rushikesh3982/tdeck-phone/case/README.md

# Case files

Modified from **"Lilygo T-Deck TD1 Case" by Alley Cat**, Printables model 741124,
https://www.printables.com/model/741124-lilygo-t-deck-td1-case, licensed
[CC BY-SA 4.0](https://creativecommons.org/licenses/by-sa/4.0/). The STL files and images in this folder are
changed versions of that design and are shared under the same licence, CC BY-SA 4.0. The originals are on
Printables. (The script in `scripts/` is MIT, like the rest of the repository.)

> **Print these cases in ASA only.** Every file here is built 1 % larger to allow for how much ASA shrinks as it
> cools, and that is what fits the T-Deck and the parts. PLA, PLA+ and PETG shrink less, so in those the parts come
> out too large and the T-Deck sits loose. ASA also stands up to the heat of a pocket or a car far better than PLA.

**Folders:** one per version of the case, each with `stl/` (every piece to print, already 1 % larger: print them at
100 % in the slicer) and `images/` (the pictures in its notes):
- [x-back-5000mah/](x-back-5000mah/): the build described on this page, the X back with the 5000 mAh pouch.
- [18650/](18650/): the slimmer 18650 version, described in [../docs/design-18650.md](../docs/design-18650.md).

Shared by both: [scripts/](scripts/) (the programs that make the STL files and pictures) and [logo/](logo/) (the
logos they engrave).

| File | What it is | Changed from |
|---|---|---|
| [x-back-5000mah/stl/front-earpiece-mic.stl](x-back-5000mah/stl/front-earpiece-mic.stl) | Front, with earpiece grille, mic pocket, a second SMA antenna cut-out, a microSD-direction picture beside the microSD opening, Alley Cat's left-side switch mount kept for the modem's SS-12F15 switch, and Alley Cat's cat-head logo on the top-edge badge | `Alley Chat TD1 Standard Front GPS Inserts.stl` |
| [x-back-5000mah/stl/earpiece-holder.stl](x-back-5000mah/stl/earpiece-holder.stl) | Small block that fills the earpiece pocket and holds the earpiece on the grille slot | new part, sized to the front's pocket |
| [x-back-5000mah/stl/back-modem-gps.stl](x-back-5000mah/stl/back-modem-gps.stl) | Back with modem standoffs, SIM slit (with a picture showing which way the card goes), GPS patch cradle, network-LED window, the back's half of the old GPS-module slot filled, and the rushiWorks logo on the outside (first version: print and dry-fit) | `Alley Chat TD1 X Back Outside Cat Edition.stl` |

Alley Cat's small parts are included **unchanged**, copied from the same Printables download (same licence and
credit). They're only scaled by 1 % like the rest of the set (see the folder note below), and copied into each
version's folder, so everything to print for this build is in [x-back-5000mah/stl/](x-back-5000mah/stl/):

| File | What it is | Original file |
|---|---|---|
| [x-back-5000mah/stl/alley-chat-td1-switch.stl](x-back-5000mah/stl/alley-chat-td1-switch.stl) | Slider for the T-Deck's own power switch (right side). Needed | `Alley Chat TD1 Switch.stl` |
| [x-back-5000mah/stl/alley-chat-td1-reset-button.stl](x-back-5000mah/stl/alley-chat-td1-reset-button.stl) | Button for the T-Deck's reset (left side). Needed if you want to reach reset from outside | `Alley Chat TD1 Reset Button.stl` |
| [x-back-5000mah/stl/alley-chat-td1-x-antenna-plug-gsm.stl](x-back-5000mah/stl/alley-chat-td1-x-antenna-plug-gsm.stl), [...-lora.stl](x-back-5000mah/stl/alley-chat-td1-x-antenna-plug-lora.stl) | Blanks off an SMA hole that has no connector in it: two identical copies, one for the 4G (GSM) hole (top-right) and one for the LoRa hole (top-left). **Needed only for a hole left empty**, for example the 4G hole with an internal antenna. With SMA antennas, both holes carry a connector (LoRa top-left, 4G top-right) | `Alley Chat TD1 X Antenna Plug.stl` |

**Size:** the files are **built 1 % larger** than Alley Cat's originals, because that's what fits our T-Deck in ASA
(see [Fit and scale](#fit-and-scale-asa-101-)). They're already scaled, so **print them at 100 % in the slicer**.

**Assembly diagrams** (what every cut-out is for, and where each part goes) and the step-by-step assembly order are in
[../docs/assembly.md](../docs/assembly.md).

## 18650 version (print files ready in 18650/stl/)

A slimmer phone, 26.5 mm instead of 37, with one 18650 cell in a grip across the top of the back. Everything about it
is in [../docs/design-18650.md](../docs/design-18650.md), including which files to print and how. Three scripts make
its parts, and the 101 % print files are in [18650/stl/](18650/stl/): `back-18650.stl` (saved standing on its top
edge, as it prints), `front-18650.stl` and `earpiece-holder-18650.stl`, with copies of Alley Cat's small parts (the
switch slider, the reset button and two antenna plugs), so the folder has every piece to print.

| Script | Part | Changed from |
|---|---|---|
| [scripts/make_back_18650.py](scripts/make_back_18650.py) | Back: the grip and the cell's channel, the modem board below it on 8 mm standoffs, the modem switch on the right wall (Alley Cat's slot and screw holes, copied from her front), the network-light window, the open GPS top slot, two ribs at each end of the cell to hold a battery contact, with + and − engraved beside them, and a thin wall along the cell that carries the protection board, with slits for its nickel strips. Grooves outside, no logo. Her cat and "Alley Chat TD1 S" stay inside | `Alley Chat TD1 S Inside Cat Edition.stl`, 0.5 mm deeper |
| [scripts/make_front_18650.py](scripts/make_front_18650.py) | Front: the SIM slit in a finger scoop, Alley Cat's speaker cavity and grille moved to the right side, larger SIM and microSD pictures, the wider and lower earpiece pocket, a notch in each side wall for a battery contact's top, and the rushiWorks logo on the top badge | the front above (`make_front.py`) |
| [scripts/make_earpiece_holder_18650.py](scripts/make_earpiece_holder_18650.py) | Low earpiece holder, with a flat roof for the GPS antenna to stand on | the earpiece holder below |

The rest of this page describes the current build.

## Front: what changed

Only these changes were made. The outer size and everything else are exactly as the original.

**Earpiece grille.** A 1 × 6 mm slot with rounded ends goes through the 3.6 mm face above the screen. It is
centred under the GPS pocket, which measures 16.4 × 7.3 mm inside.

- The receiver (the Micromax one) lies on the pocket floor, facing the slot, with its rubber gasket against the floor.
  It is 12 × 6 mm and 2 mm thick with the gasket. Its two spring contacts, folded over its back at the short
  ends, make it 3 mm.
- The [earpiece holder](#earpiece-holder) goes in on top of it and keeps it pressed down.

**Microphone.** In the bottom edge, 15 mm left of the USB-C opening as you look at the screen. This is the corner
that points toward your mouth when the phone is at your right ear.

- **The mic:** Sunrom 6027 ([sunrom.com/m/5522](https://www.sunrom.com/m/5522)). Its datasheet gives:
  - **Body:** Ø6.0 ± 0.2 mm, 2.7 ± 0.2 mm tall.
  - **Pins:** two, 2.8 mm long, 0.4 mm thick, 1.9 mm apart.
- **Pocket:** 6.3 mm round, opening on the inside of the case. That leaves 0.1–0.5 mm of play around the mic. Its top
  is pointed (a "teardrop") so it prints without supports.
- **Skin and sound hole:** 1.2 mm of plastic is left at the outside, with a 1.5 mm sound hole through it.
- **Fitting the mic, before the T-Deck goes in:** the pocket opens on the inside face of the bottom wall, which
  the T-Deck covers once it's in. Push the Sunrom 6027 (6 × 2.7 mm) in from inside until it touches the skin. Hold
  it with a dab of glue, lay its wires in the groove, then fit the T-Deck.
- **Wire groove:** a 2.4 mm groove runs from the pocket up the inside wall and through the mating lip, so the
  two mic wires reach the back half without the T-Deck pinching them.
- **Pins and wires:**
  - **Space behind the mic:** the pocket stays open behind the mic body all the way into the case. The only thing
    nearby is the T-Deck's back edge, which reaches 1.3 mm up the pocket's lower (screen-side) edge.
  - **Turn the mic so its two pins sit side by side,** both at the mic's centre height, level with each other and
    parallel to the screen. Then both solder joints are 1.7 mm clear of the T-Deck, and in line with the groove.
  - **Trim the pins to about 1.5 mm,** solder a thin wire to each, and bend the wires up into the groove. Don't let a
    joint hang toward the screen side.

**Alley Cat's cat-head logo on the top-edge badge.** It's a visible credit to the case's designer.

- **Badge:** the original badge (cat ears + GPS pin) is replaced by a fresh one of the same footprint: a 1 mm raised
  pad with 45° bevels and a 16.8 × 10.5 mm face.
- **The cat:** the cat head is taken from Alley Cat's own TD1 files, and is the same cat as on her *Alley Chat HT
  Pocket* case (see [logo/](logo/)). It's 9.4 mm tall and cut the same way as on the HT Pocket: the head recessed
  0.35 mm, the closed eyes and nose 0.7 mm deep.
- **Orientation:** it reads upright when the phone lies screen-up, with the ears toward the screen side.

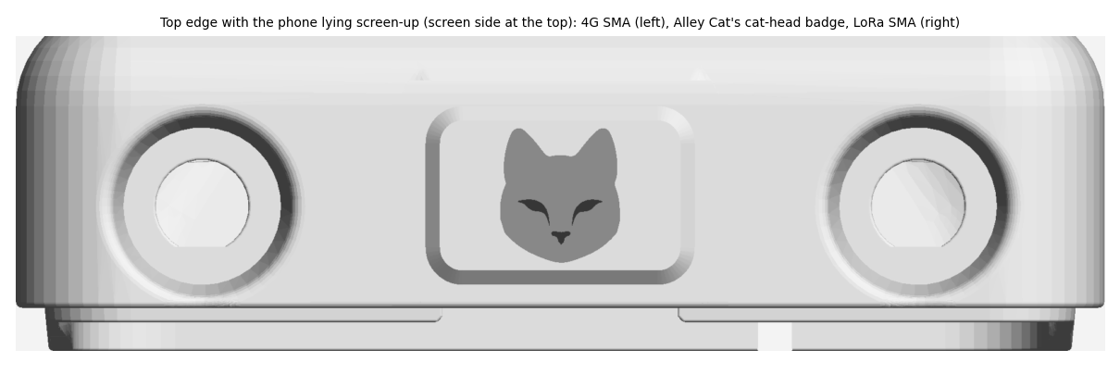
[picture p1: case/images/front-top-edge.png]
Top edge with the phone screen-up: 4G SMA cut-out, Alley Cat's cat-head badge, LoRa SMA cut-out


**Modem switch mount (Alley Cat's original, kept).** The GPS version's slide-switch mount on the left side holds
the modem's on/off switch, an **SS-12F15**. That's the switch the mount was drawn for, with the same 15 mm screw
spacing and 2.2 mm holes.
- **Fitting:** the 19.7 × 5.6 mm plate sits in the 21.6 × 8.4 mm recess inside the wall, held by two M2 countersunk
  screws from outside with nuts inside. The 4 mm knob comes out through the 6.9 × 3.4 mm slot and stands 1 mm proud.
- **Checked against the case files:** the switch, with its knob over its full travel, touches neither half. It sits
  0.5 mm above the T-Deck's back, and its pins point into the case.
- **Battery:** it moves about 9 mm toward the phone's right to clear the switch's body and pins (2.5 mm gap).
- **History:** this mount was filled in an earlier version, when the modem was to follow the T-Deck's own switch. It
  is now exactly as in Alley Cat's file. The Reset Button opening just below is unchanged too.

**Second SMA antenna cut-out (top-right corner).** The Grove socket is desoldered from the T-Deck and the modem
wires are soldered to its pads, so the Grove plug slot in that corner is no longer needed. It is filled in, and the
corner gets an exact mirror image of the case's own SMA cut-out from the top-left corner. Its fit with the KTRON
IPX → SMA-female cable (KSTA0380):

| Cut-out (both corners) | Size | KTRON connector | Fit |
|---|---|---|---|
| Hole through the wall | Ø 6.56 mm | SMA thread 6.35 mm | ✓ 0.2 mm clearance |
| Hex pocket on the inside, 3 mm deep | 8.4 mm across flats | 8 mm hex collar | ✓ snug, and stops it turning when the antenna is tightened |
| Nut recess on the outside, 2.8 mm deep | Ø 12 mm | 8 mm nut + lock washer | ✓ sits just below the surface |
| Wall | 2 mm | 9.5 mm thread (typical) | leaves about 4.7 mm outside for the antenna. Measure yours: it needs at least 9 mm |

- **Check on the T-Deck before printing:** the case's wall block in that corner is 7.8 mm deep. The connector's
  hex collar, crimp and heat-shrink reach about 11–16 mm in from the outer surface. So 3–8 mm of it goes past the
  T-Deck's top edge, level with the T-Deck's back surface. With the Grove socket removed, hold the connector in
  that corner and check that nothing on the T-Deck is in the way. In the top-left corner, the LoRa connector already
  uses the same space.
- **Which antenna where:** see below.

Both top corners now have identical SMA cut-outs, so either antenna can go in either corner. **Recommended:** 4G
in the top-right, and the T-Deck's LoRa connector staying top-left, where it already sits.
From the top-right, the 4G cable drops straight into the empty strip beside the modem board, to its 4G socket on
that side (about 5 cm; the 10 cm cable is plenty). From the top-left, it would have to get around the battery,
which covers the board with only about 1 mm to spare (about 11 cm, so use the 15 cm cable).

**microSD picture (right side, added 7 Nov 2026).** An engraved microSD outline, 5.9 × 8 mm and 0.8 mm deep, on the
flat wall beside Alley Cat's microSD opening. It sits toward the phone's top, at the opening's height, matching the
SIM picture on the back.
- **What's on it:** the card's narrow front section with its step, four raised stripes for the gold contacts, and a
  raised arrow.
- **How to read it:** with the phone screen-up, the picture's top edge (the contacts end) goes in first. The gold
  contacts face up, toward the screen, which is why they're drawn. The narrow section with its step is on the
  USB-end side.
- **Where the direction comes from:** the owner's photo of a card beside the T-Deck's slot, 7 Nov 2026. LilyGO's
  documentation doesn't say which way it goes.

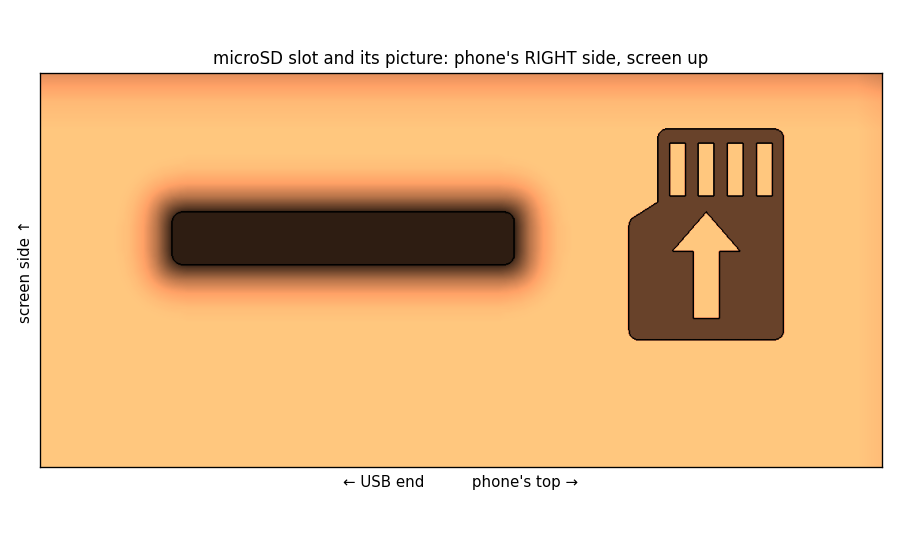
[picture p2: case/images/sd-picture.png]
The microSD opening and the picture beside it, on the phone's right side


## Earpiece holder

[x-back-5000mah/stl/earpiece-holder.stl](x-back-5000mah/stl/earpiece-holder.stl) is a new printed part, 16.0 × 6.9 × 16.5 mm. It fills the front's old
GPS-module pocket and keeps the earpiece pressed onto the grille slot. In the GPS version of the case, the
module's slot ran from the front up into the back. The back's half is now filled solid (see the back changes
below), so the holder only fills the front's part.

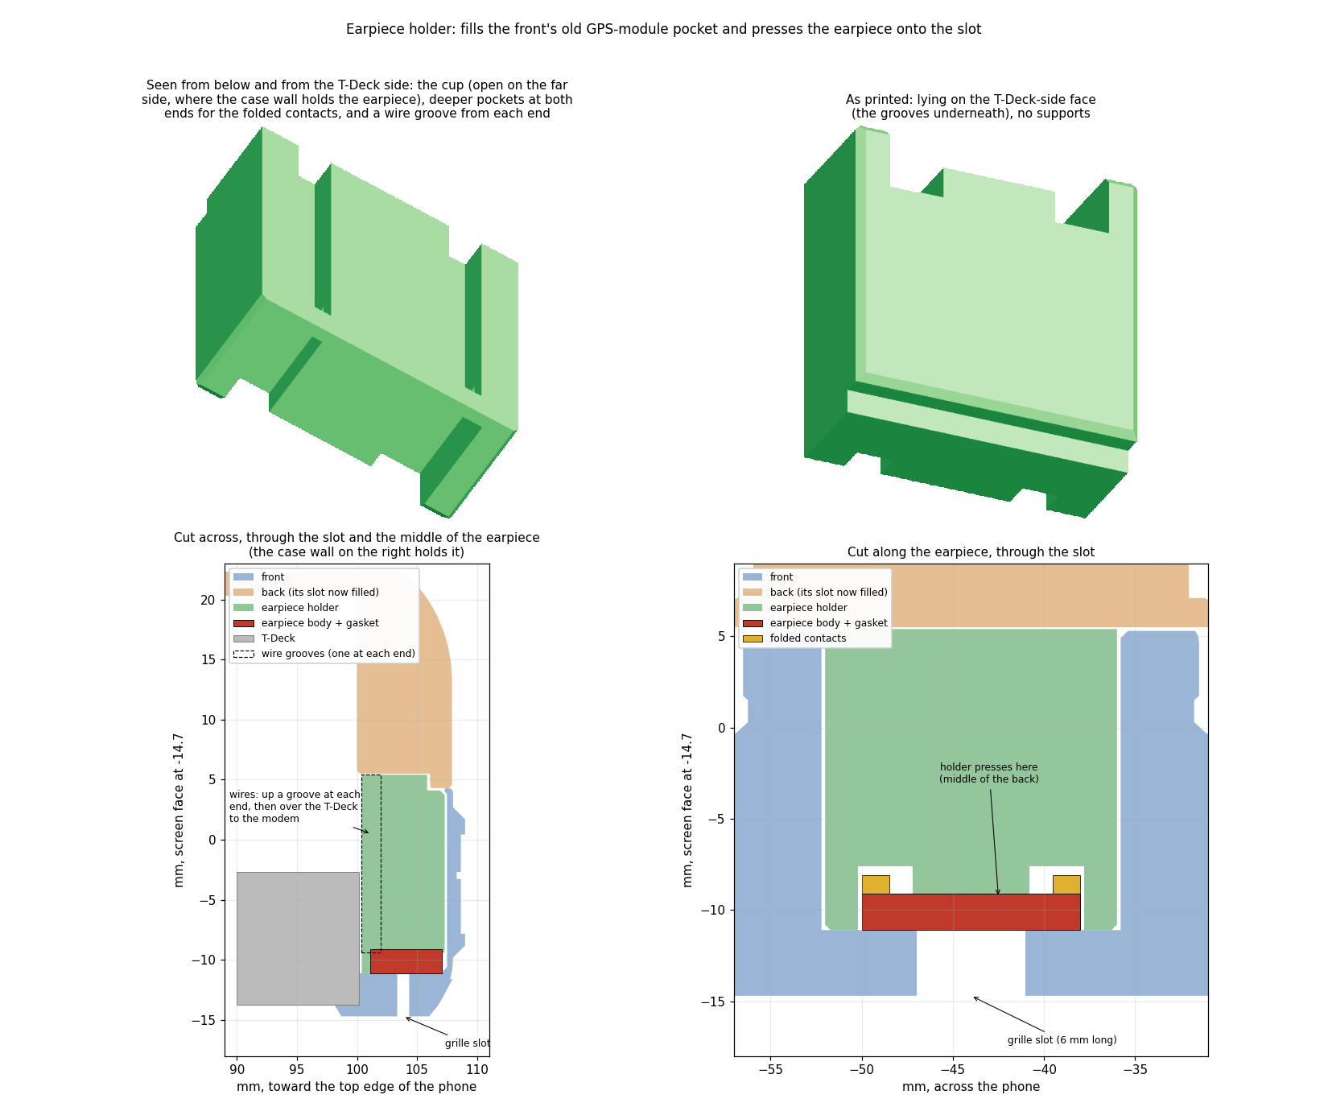
[picture p3: case/images/earpiece-holder.png]
Earpiece holder: views, and a cut through the closed case


- **Cup:** the earpiece sits in a 12.4 mm long cup on the holder's underside, over the slot.
  - **Sides:** the holder is only 6.9 mm wide, too narrow for a wall on both sides of a 6 mm earpiece. So the cup
    has a 0.7 mm wall on the T-Deck side only, and is open on the far side. There the pocket's own wall holds the
    earpiece, with 6.4 mm of room between the two walls.
  - **Middle:** the cup is 1.7 mm deep here, and the holder presses on the middle of the earpiece's back. That squeezes
    the 2 mm body and gasket 0.3 mm onto the pocket floor, sealing the sound path to the slot.
  - **Ends:** over the last 3 mm at each end the cup is 3.5 mm deep. That leaves room for the folded contacts (1 mm)
    and their solder joints.
- **Held by the back:** the holder stands on the pocket floor, and its top ends 0.1 mm under the back's filled block.
  Once the case is closed, it can't lift.
- **Wires:** each end pocket has its own 2 mm groove up the face toward the T-Deck. Each wire goes straight up from
  its solder joint, then over the T-Deck to the modem.
- **Fit:** 0.2 mm clearance all round in the pocket. The script checks that it touches neither case half.
- **If your earpiece measures differently:** the length and width are set at the top of
  `scripts/make_earpiece_holder.py` (`EAR_L`, `EAR_W`). Change them and run it again.
- **Printing:** lay it on the face with the wire grooves (the face toward the T-Deck). Then no supports are needed.

## Back: what changed

**Outside.** Made from Alley Cat's *Outside Cat* edition of the X back. It has the same vertical grooves, with the
three middle ones shortened, which leaves a clear area near the top. That area had a cat-head outline engraved in
it. The cat is filled flush, and the **rushiWorks logo** is engraved in its place:

- **Size:** 24 × 17 mm, 1 mm deep, matching the grooves. The letter strokes are about 0.8 mm wide.
- **Clearances:** it stays clear of the grooves and of the two case-screw countersinks.
- **Orientation:** it reads normally when you look at the back with the phone upright.
- **Printing:** the back prints face-down, so the logo forms in the first layers and comes out crisp.
- **Inside:** identical to the Inside Cat edition, so all the changes below are the same with either.
- **Inside floor:** Alley Cat's engraved cat head and "Alley Chat TD1 X" text (hidden once assembled) are filled
  flat. The designer is credited by the badge kept on the front's top edge and in the README.

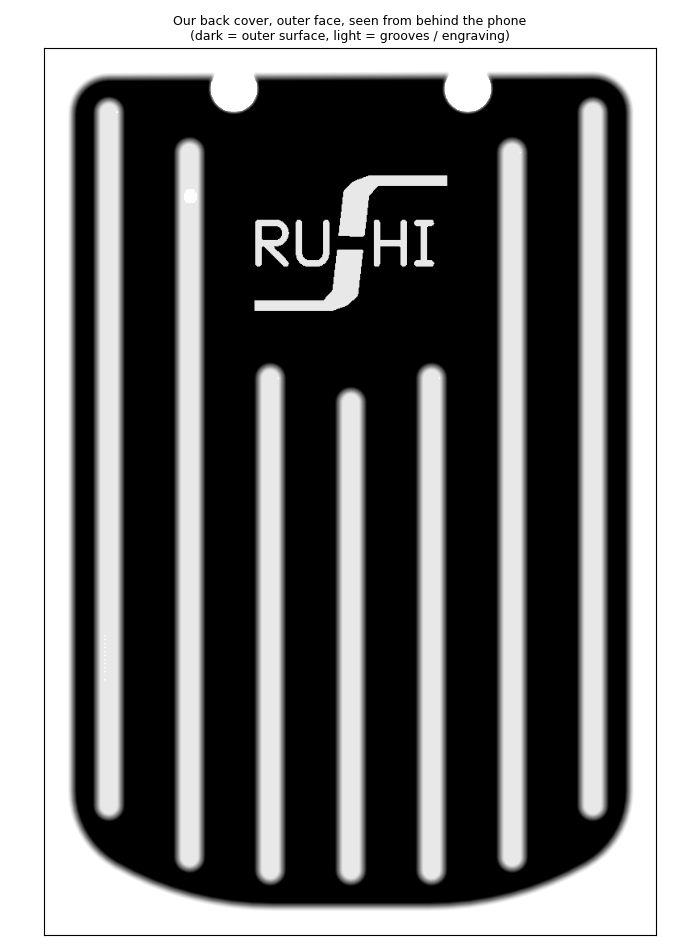
[picture p4: case/images/back-outside.png]
Back cover from outside: Outside Cat groove layout with the rushiWorks logo


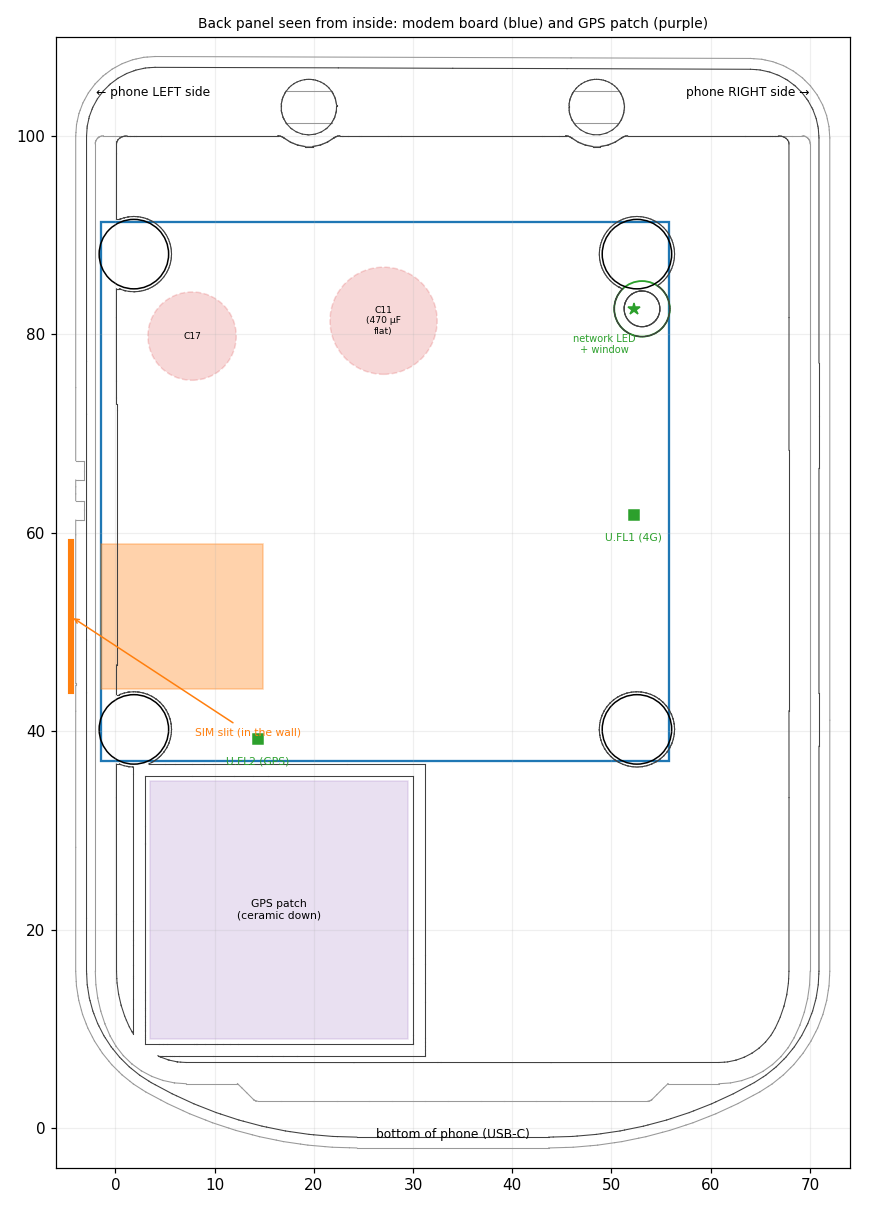
[picture p5: case/x-back-5000mah/images/back-layout.png]
Back from inside: layout of the modem board and GPS patch


**Old GPS-module slot filled.** The GPS version's module slot continued from the front's pocket up into the back:
16.4 × 6.1 mm, 10 mm tall, in the thick block between the two case-screw holes. Only the earpiece uses the
front's part of it now, so the back's part is filled solid. The fill copies the block's cross-section from just beside
the slot, so the block now runs unbroken between the screw holes and caps the earpiece holder.

**Layout change (7 Nov 2026), after the dry fit:**
- **The problem:** the earpiece wires come down from the top, past the filled block between the case screws. The
  board and battery left them only about 1.5 mm.
- **What moved:**
  - **The GPS patch:** 5 mm left and 4 mm down, as far into the bottom-left corner as it can go with its ceramic
    still flat on the pads. Its fence merges into the curved corner.
  - **The modem board:** 7 mm down, with its standoffs, the SIM slit and its picture, and the network-LED window.
  - **The battery and protection board:** 7 mm down too, so the J3 pads stay at the battery's top end.
- **The result:**
  - about 8.5 mm between the battery's top end and the block, room for the earpiece wires;
  - about 5 mm more between the GPS patch and the internal 4G sticker antenna (about 28 mm edge to edge).

**Modem standoffs.** Four columns at the KTRON board's holes.

- **Board:** the KTRON is 54.33 × 57.23 mm, with its holes on a 47.90 × 50.70 mm rectangle.
- **Columns:** 7 mm wide, with a 10 mm foot, and their tops 9 mm above the inside floor. The two next to the left
  wall are joined to it.
- **Trimmed to the case's shape:** the cover's bottom edge is rounded, so near the floor its outside face curves in.
  The two left columns' feet used to poke up to 1.5 mm out through that curve. Everything added to the back is now
  trimmed to the original cover's outer shape, so nothing shows outside (fixed 6 Nov 2026).

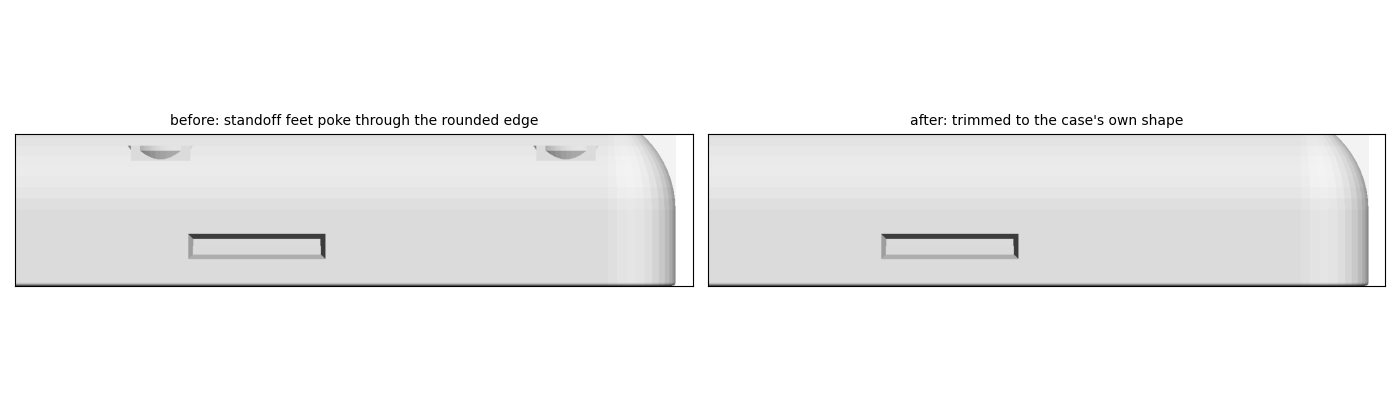
[picture p6: case/images/back-left-edge-fix.png]
Left side of the back from outside, before and after the fix
  
- **Inserts:** each column has a 4.5 mm hole, 6 mm deep, for an M3 × 5 heat-set insert. The board is held with
  M3 × 6 screws from its solder side.
- **Board orientation:** component side down toward the back cover. The SIM edge faces the phone's left side,
  0.6 mm from the wall. The 4G socket faces right, and the GPS socket is at the bottom, just above the patch.
- **9 mm only works after the capacitor swap.** The KTRON's two 11 mm tall capacitors are replaced by radial
  ones laid flat (see [../docs/bring-up.md](../docs/bring-up.md), phase B). Nothing on the board's component side
  may stand more than 8 mm high.

**SIM slit.** Through the left side wall, in line with the SIM holder.

- **Size:** 15 × 1.8 mm on the inside, flaring to about 16 × 3 mm on the outside so the card finds its way in.
- **Position:** its centre is 11.35 mm above the inside floor and 4.65 mm below the rim, so it is entirely in the
  back panel. That is the card's height in a standard 1.5 mm push-push micro-SIM holder sitting on a board on 9 mm
  standoffs.
- **Using it:** push the card in until it clicks, using a fingernail or a SIM pin. Push again to release it, then
  pull it out.
- **SIM size:** a nano-SIM in a micro adapter can catch in push-push holders. A fresh multi-cut SIM, popped out at
  micro size, is safer.
- **Which way (picture beside the slit, added 7 Nov 2026):** a micro-SIM outline, 6 × 7.5 mm and 0.8 mm deep,
  with its cut corner and a raised arrow. It's on the flat wall just beside the slit, toward the phone's top, at
  the slit's height.
  - **How to read it:** it's the card as it should look going in, with the phone screen-up. The picture's top edge
    goes in first. The face you see is the face that's up, so the gold contacts face down. The cut corner is on the
    outer end, toward the phone's USB end.
  - **Why it's needed:** turned end-to-end, the card still clicks in but isn't read.
  - **How it was checked:** on the board and against KTRON's own photo.
  - **Why beside the slit:** a first version sat under the slit, but the wall there is flat for only about 3 mm
    before it curves into the back's rounded edge, which spoiled it.

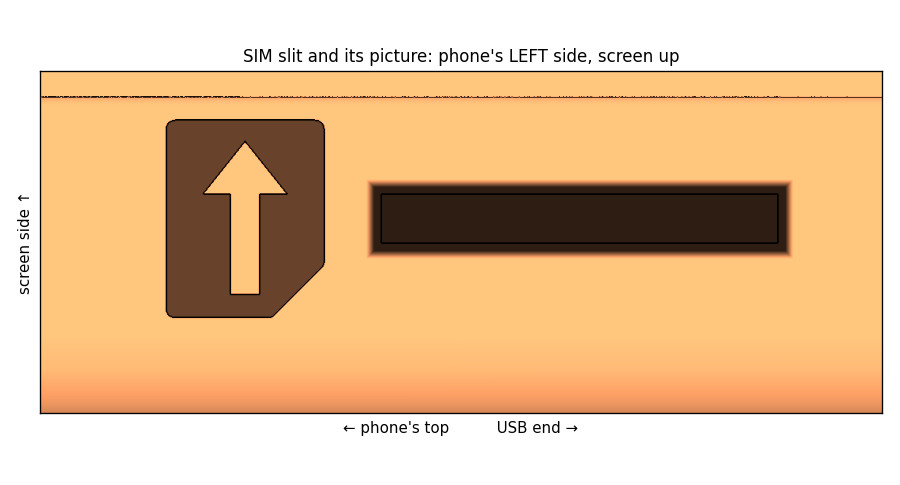
[picture p7: case/x-back-5000mah/images/sim-picture.png]
The SIM slit and the picture beside it, on the phone's left side
  

The SIM slit is also shown from outside in the "after" half of the picture under *Modem standoffs* above (drawn
before the SIM picture was added).

**GPS patch cradle.** A fence with a 27 mm square opening in the bottom-left corner. It is sized for the measured patch:
26 × 26 mm board and a 25 × 25 × 4 mm ceramic that sits slightly crooked.

- **Pads:** the ceramic faces down and rests on four 3 mm pads, 0.5 mm high, so it stays just off the cover.
- **Fence:** 7 mm tall.
- **Cable notches:** 4 mm wide, in every side, for the cable that leaves the middle of one side of the board.
- **Fixing:** a dab of hot glue at two corners. The 95 mm cable easily reaches the GPS socket, just above the patch.

**Network LED window.** The KTRON's network LED (NETLIGHT) faces the back cover from 9 mm up.

- **Light tube:** 3.6 mm bore, from the floor to 1.6 mm under the board, so the light goes straight out and the
  power LED next to it doesn't leak through.
- **Hole:** 1.6 mm through the cover, on the flat floor of the decorative groove beside the LED (1 mm thick there).
- **Where it shows:** near the top of the back, on the phone's right side. When you look at the back, that's the
  top-left area.
- **Blink pattern** (SIMCom): lit steadily while searching for the network; 200 ms on / 200 ms off once
  registered.
- **Optional:** a drop of clear glue or UV resin seals the hole and spreads the light.

**Internal LTE antenna option.** The full-band LTE sticker antenna (110 × 20 mm) can go along the inside of the back's
right side, wrapped from the floor up the wall. It needs no change to the case files. The band beside the modem board is
about 7.5 mm of flat floor, a curve, and 16 mm of wall, about 91 mm long. Details, and how to decide by measuring, are
in [../docs/wiring.md](../docs/wiring.md), section 6. With it, the top-right SMA hole takes the antenna plug.

**Depth** (inside floor to the T-Deck's back, 23 mm with LilyGO's 11 mm T-Deck): 9 standoffs + 1.6 board + 1.5 SIM
holder + 1 foam + 9 battery = 22.1 mm. The battery (65 × 55 × 9 mm) lies over the board, its long side running top
to bottom, with its connector end toward the bottom, over the patch.

## Fit and scale (ASA, 101 %)

**Our result (7 Nov 2026):** the parts built at **101 %**, printed in **ASA**, fit the T-Deck and all the parts
well. That matches other builders' reports: ASA shrinks a little more than PLA or PETG as it cools. So the
files in each version's `stl/` folder are the 101 % set, for ASA only.

**The T-Deck's fit is tight on purpose.** For the first 5 mm above the screen face, the front's inside is exactly
68.00 mm wide. That's LilyGO's width for the T-Deck, with no clearance. Above that, a 1.5 mm tall ridge narrows it to
67.4–67.5 mm. The ridge snaps over the T-Deck's sides and holds it without screws, and the case is meant to flex as
the T-Deck goes in. So whether it fits depends on how your printer and filament come out, to a few tenths of a
millimetre.

**What other builders report** (Printables comments, 2024–2026):
- Most printed at 100 % in PETG, PLA, PLA+ or ABS and say it "fits like a glove". The designer uses PETG.
- Those printing ASA needed 0.5–1 % larger. ASA shrinks more as it cools.
- One printed at 102 % and needed a shim to stop the T-Deck shifting, so 102 % was too big for them.
- The designer's own advice: "if it's too tight, print it slightly larger".
- It does **not** fit the T-Deck Plus, which is a different, larger device (115 × 72 × 20 mm). This case is for the
  original T-Deck (100 × 68 × 11 mm).

**Only ASA:** the case is designed and sized for ASA. PLA, PLA+ and PETG shrink less, so their parts would come out
about 1 % too large and the T-Deck would sit loose.

**Don't scale files in the slicer.** Scaling in the slicer would also move the parts we added. At 101 %, the modem standoffs would be 0.5 mm further apart than
the board's holes, and the M3 screws only have 0.2 mm of play in them. The 101 % set is built with the scripts'
`--scale 1.01` option instead:
- **Back:** everything grows with Alley Cat's shell except the four modem standoffs. They keep the board's exact
  47.90 × 50.70 mm spacing and 4.5 mm insert holes, so the board still screws on. Checked: same spacing, nothing
  sticks out of the cover, and the SIM slit stays in line with the card (0.02 mm apart).
- **Front:** scaled as a whole. Nothing in it has to stay true within 1 %: the mic pocket goes from 6.30 to 6.36 mm.
  The T-Deck opening becomes 68.68 mm.
- **Earpiece holder:** its outside grows with the pocket, but the earpiece cup stays true to size. Checked: it touches
  neither half.
- **Switch, Reset Button, Antenna Plug:** scaled by 1 %, because they fit openings in the case.
- **18650 version:** the parts that must match real parts are built at their true size in the scaled case too: the
  standoffs, the cell's channel, the battery contacts' holders and the modem switch's mount.

## Printing

- Print the files as they are oriented, outer face down on the bed (the screen side for the front), with no
  supports. The earpiece slot is vertical, the mic pocket has a 45° roof, and the back's standoffs and cradle grow
  straight up.
- **ASA only**; 0.2 mm layers, 3 perimeters, 20 % infill.
- **Heat-set inserts:** iron at about 240–255 °C. Let the insert sink under light pressure and stop when it's flush.
  Ventilate when heating ASA.
- The earpiece holder is the exception: lay it on its wire-groove face (see [Earpiece holder](#earpiece-holder)).
- In the slicer preview, check that the 1 mm slot and the 1.5 mm sound hole are open.
- **The 18650 version** prints differently (its back stands on its top edge): see
  [../docs/design-18650.md](../docs/design-18650.md#printing).

## Making the files again

The scripts make every part from Alley Cat's original Printables files. All sizes are set at the top of each
script. They need Python with numpy, trimesh, shapely and manifold3d. Run them from this `case/` folder, with the
original files beside it.

The print set in [x-back-5000mah/stl/](x-back-5000mah/stl/), at 101 %:

```
python scripts/make_front.py --scale 1.01 "Alley Chat TD1 Standard Front GPS Inserts.stl" x-back-5000mah/stl/front-earpiece-mic.stl
python scripts/make_back.py --scale 1.01 "Alley Chat TD1 X Back Outside Cat Edition.stl" x-back-5000mah/stl/back-modem-gps.stl
python scripts/make_earpiece_holder.py --scale 1.01 x-back-5000mah/stl/earpiece-holder.stl "" x-back-5000mah/stl/front-earpiece-mic.stl x-back-5000mah/stl/back-modem-gps.stl
python scripts/scale_stl.py "Alley Chat TD1 Switch.stl" x-back-5000mah/stl/alley-chat-td1-switch.stl 1.01
python scripts/scale_stl.py "Alley Chat TD1 Reset Button.stl" x-back-5000mah/stl/alley-chat-td1-reset-button.stl 1.01
python scripts/scale_stl.py "Alley Chat TD1 X Antenna Plug.stl" x-back-5000mah/stl/alley-chat-td1-x-antenna-plug-gsm.stl 1.01
cp x-back-5000mah/stl/alley-chat-td1-x-antenna-plug-gsm.stl x-back-5000mah/stl/alley-chat-td1-x-antenna-plug-lora.stl
```

The 101 % files always come from the scripts' `--scale 1.01`, never from scaling 100 % files, so the parts that must
match real parts keep their true size.

The pictures are drawn from **100 %** parts (the same scripts without `--scale`), built into a scratch folder that
isn't kept, for example `/tmp/tdeck100`:

```
mkdir -p /tmp/tdeck100
python scripts/make_front.py "Alley Chat TD1 Standard Front GPS Inserts.stl" /tmp/tdeck100/front-earpiece-mic.stl
python scripts/make_back.py "Alley Chat TD1 X Back Outside Cat Edition.stl" /tmp/tdeck100/back-modem-gps.stl x-back-5000mah/images/back-layout.png
python scripts/make_earpiece_holder.py /tmp/tdeck100/earpiece-holder.stl x-back-5000mah/images/earpiece-holder.png /tmp/tdeck100/front-earpiece-mic.stl /tmp/tdeck100/back-modem-gps.stl
python scripts/make_diagrams.py /tmp/tdeck100/front-earpiece-mic.stl /tmp/tdeck100/back-modem-gps.stl x-back-5000mah/images
```

The back script reads the logo from `logo/rushi-logo.jpg`, and also needs pillow and matplotlib to trace it.

**The 18650 version,** at 101 %, into [18650/stl/](18650/stl/). The back also reads Alley Cat's switch slot from her
front file, and the front script reads the logo:

```
python scripts/make_back_18650.py --scale 1.01 --stand "Alley Chat TD1 S Inside Cat Edition.stl" "Alley Chat TD1 Standard Front GPS Inserts.stl" 18650/stl/back-18650.stl
python scripts/make_front_18650.py --scale 1.01 "Alley Chat TD1 Standard Front GPS Inserts.stl" 18650/stl/front-18650.stl
python scripts/make_earpiece_holder_18650.py --scale 1.01 18650/stl/earpiece-holder-18650.stl
cp x-back-5000mah/stl/alley-chat-td1-switch.stl x-back-5000mah/stl/alley-chat-td1-reset-button.stl x-back-5000mah/stl/alley-chat-td1-x-antenna-plug-*.stl 18650/stl/
```

Its pictures, in [18650/images/](18650/images/), from 100 % parts (with the X back's 100 % parts above, for the
side-by-side view):

```
python scripts/make_back_18650.py "Alley Chat TD1 S Inside Cat Edition.stl" "Alley Chat TD1 Standard Front GPS Inserts.stl" /tmp/tdeck100/back-18650.stl
python scripts/make_front_18650.py "Alley Chat TD1 Standard Front GPS Inserts.stl" /tmp/tdeck100/front-18650.stl
python scripts/make_18650_pictures.py /tmp/tdeck100/back-18650.stl /tmp/tdeck100/front-18650.stl /tmp/tdeck100/back-modem-gps.stl /tmp/tdeck100/front-earpiece-mic.stl 18650/images
```
