rushikesh3982/tdeck-phone/case/logo/README.md

# Logos

| File | What | Licence |
|---|---|---|
| [rushi-logo.jpg](rushi-logo.jpg) | rushiWorks logo, engraved on the back cover | © Rushikesh Deshmukh. **Not** covered by the repository's MIT licence or by CC BY-SA. Don't reuse it |
| [alley-cat-head.json](alley-cat-head.json), [alley-cat-head.svg](alley-cat-head.svg) | Alley Cat's cat-head logo, engraved on the front's top-edge badge as a credit to the case's designer | By Alley Cat and Majestic AV, LLC, CC BY-SA 4.0 |

The cat head is taken from the engraving on the inside floor of Alley Cat's *Alley Chat TD1 X Back* files
([Printables 741124](https://www.printables.com/model/741124-lilygo-t-deck-td1-case)). Its cheek tufts are smoothed
into a plain curve so it matches the cat on her *Alley Chat HT Pocket* case. That also keeps it printable at badge
size (9.4 mm tall).

Alley Cat's cat-head logo
