rushikesh3982/tdeck-phone/case/images/alley-cat-head-candidate.png

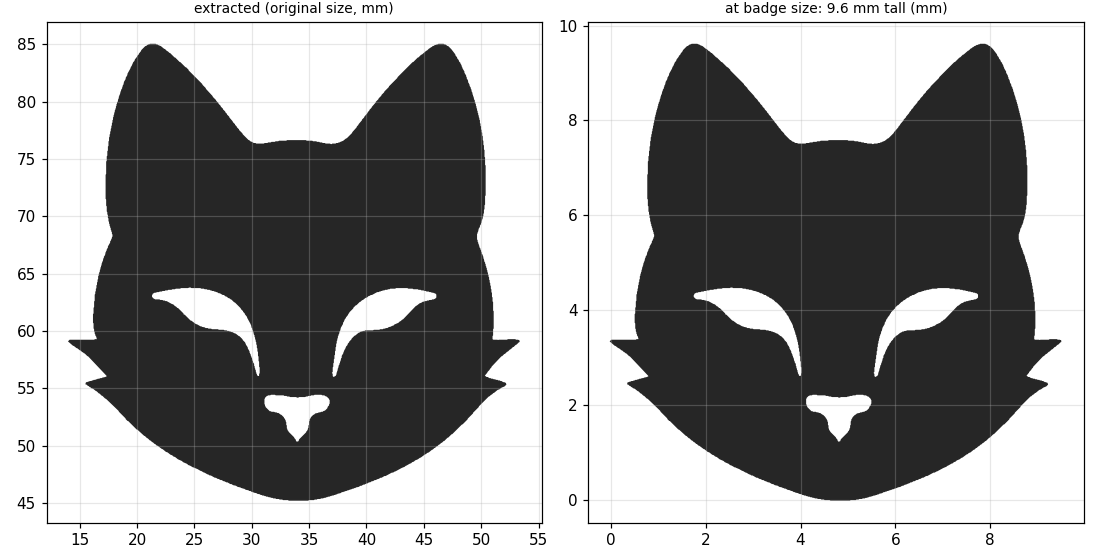
case/images/alley-cat-head-candidate.png
