rushikesh3982/tdeck-phone/case/images/back-layout.png

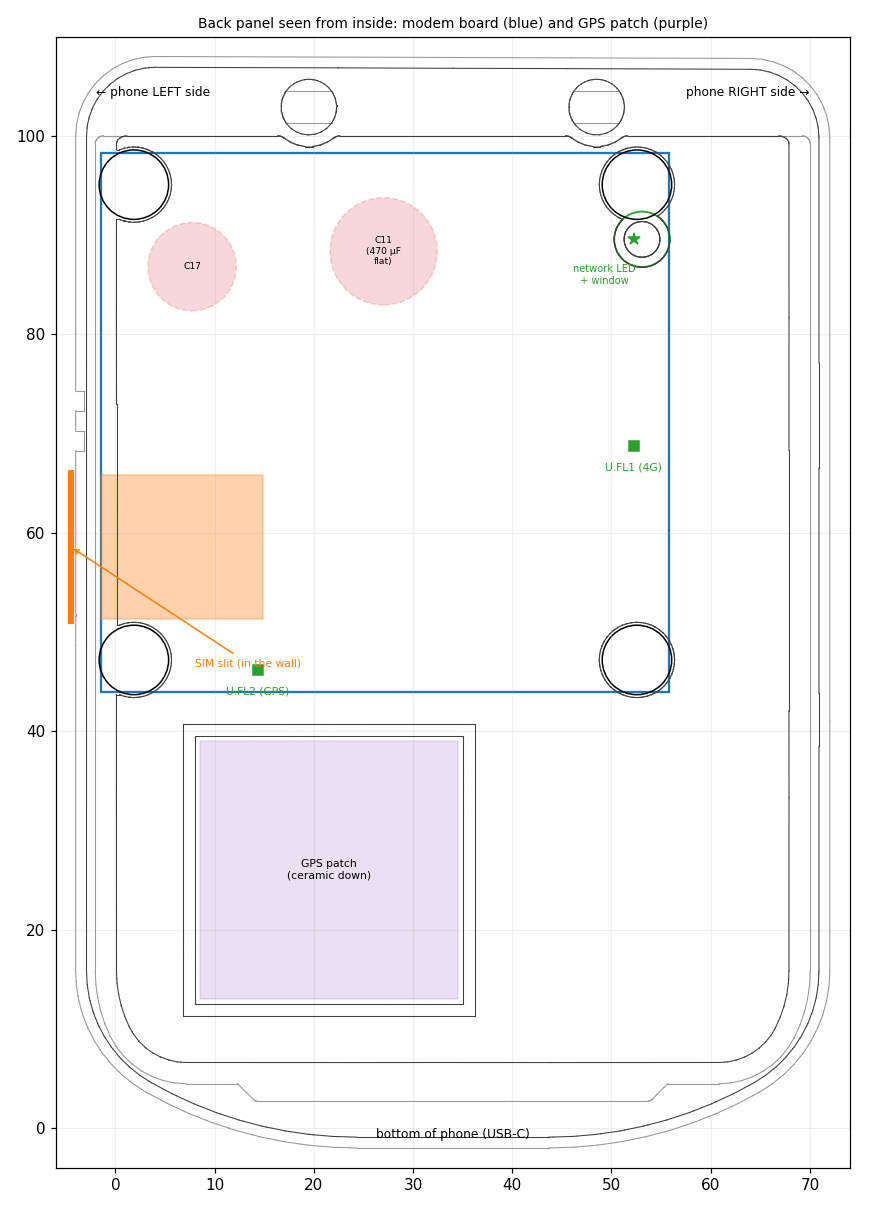
case/images/back-layout.png
