rushikesh3982/tdeck-phone/case/images/back-preview.png

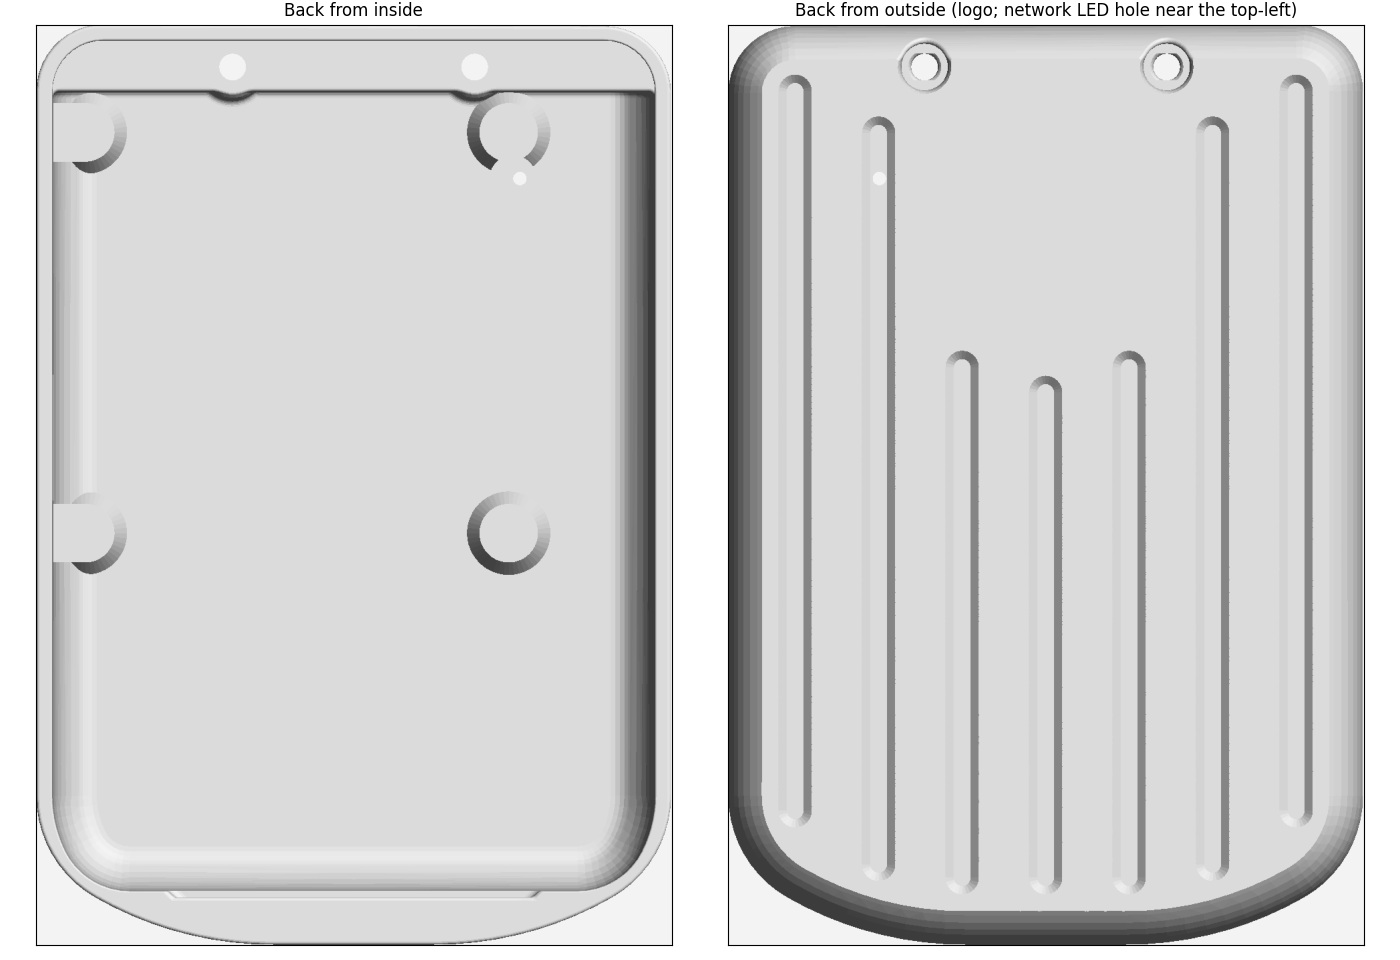
case/images/back-preview.png
