rushikesh3982/tdeck-phone/case/images/back-sim-slit.png

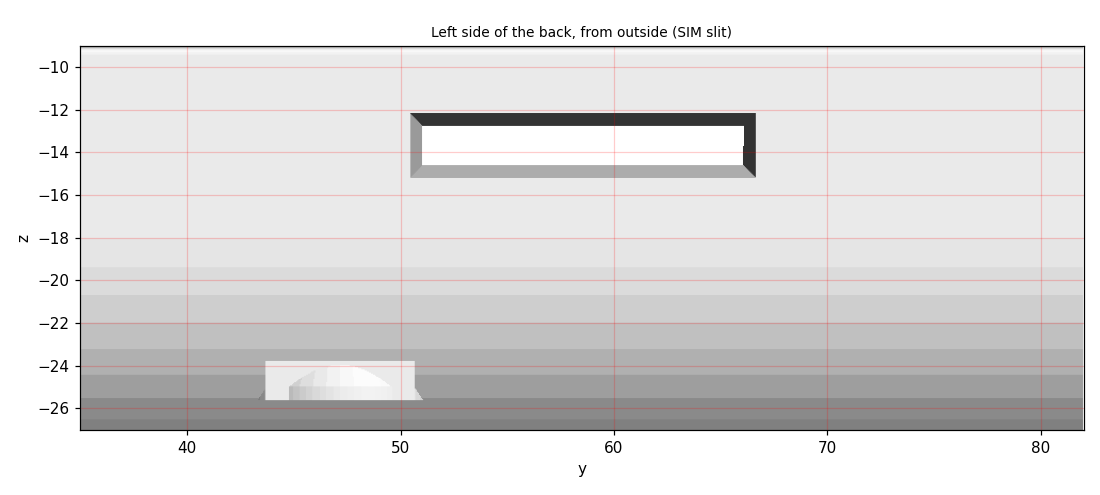
case/images/back-sim-slit.png
