rushikesh3982/tdeck-phone/case/images/front-cuts-inside.png

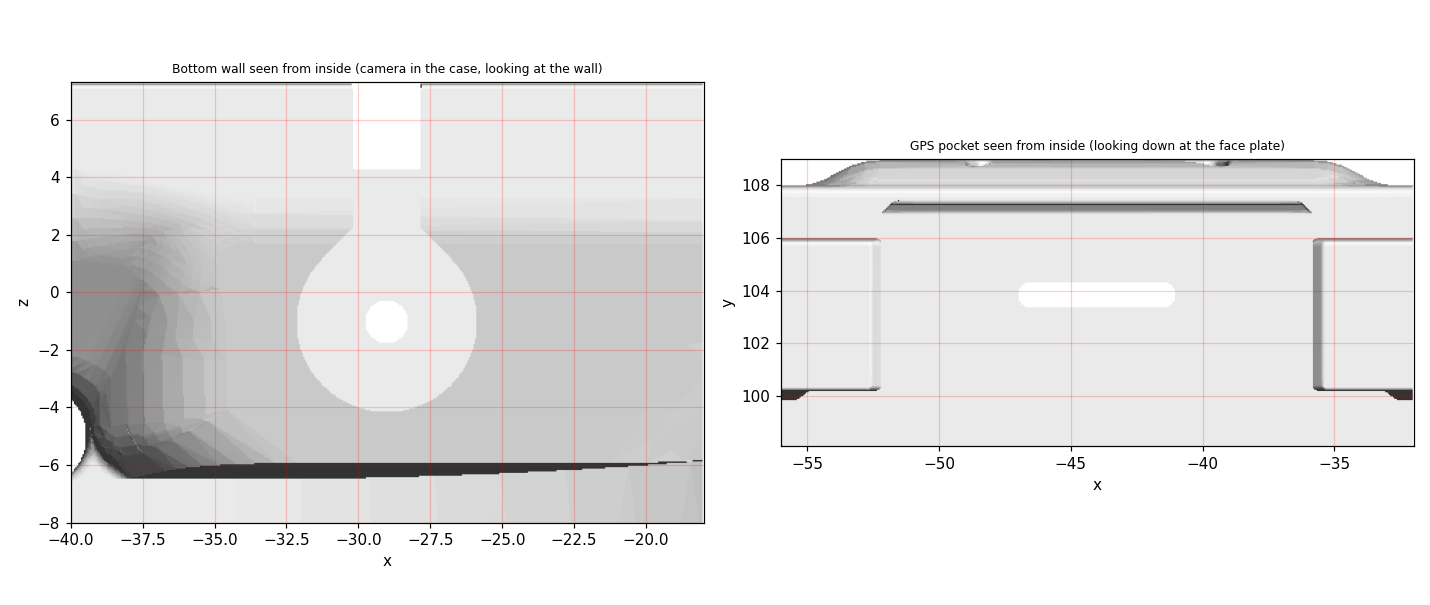
case/images/front-cuts-inside.png
