rushikesh3982/tdeck-phone/case/images/front-screen-side.png

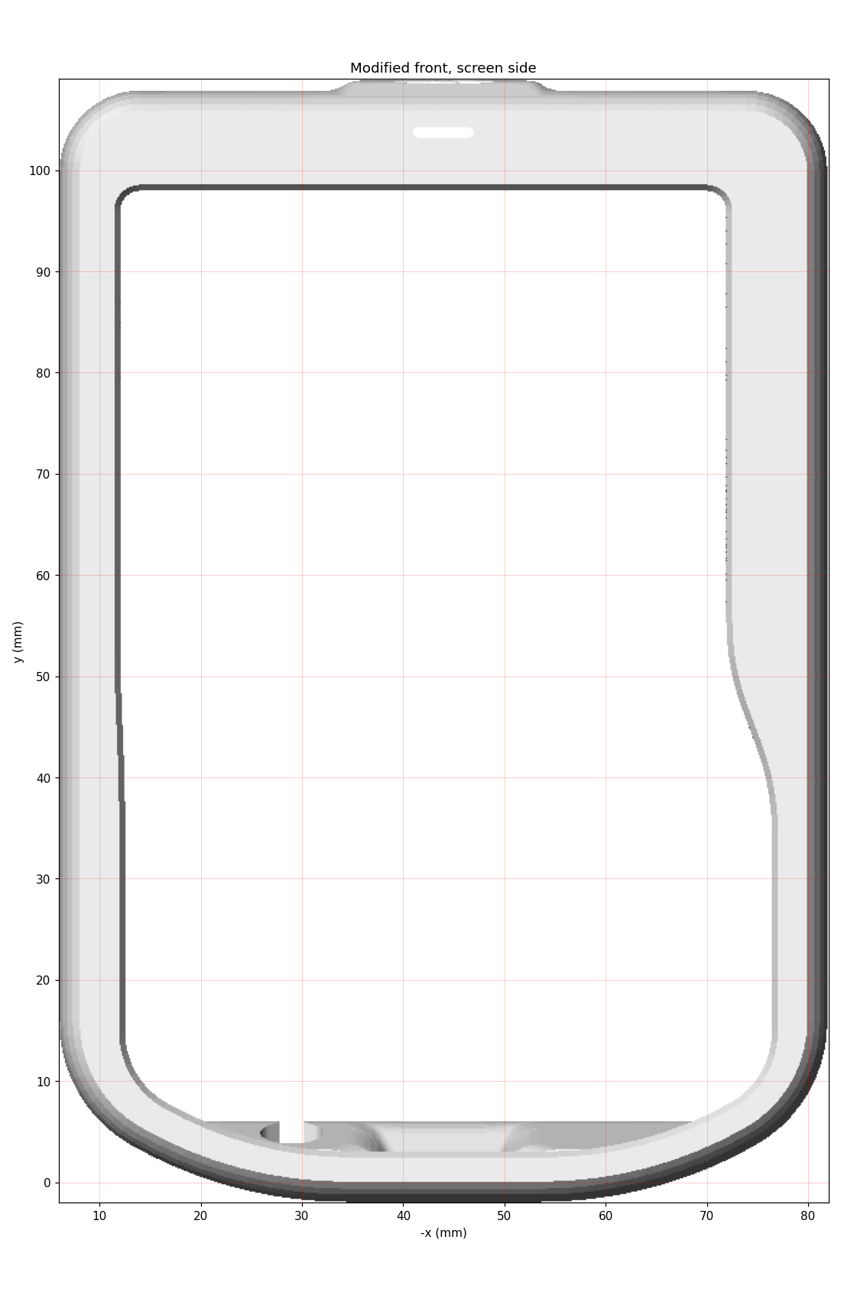
case/images/front-screen-side.png
