rushikesh3982/tdeck-phone/case/images/front-side-text.png

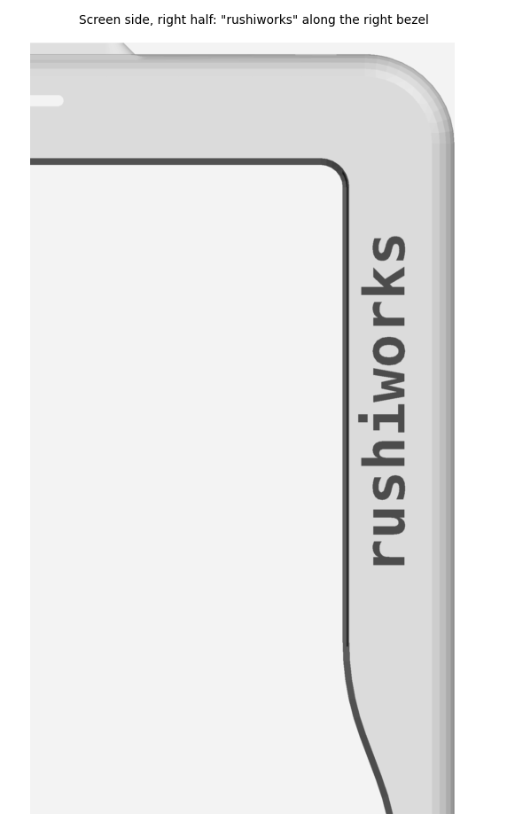
case/images/front-side-text.png
