rushikesh3982/tdeck-phone/case/images/front-top-edge-sma.png

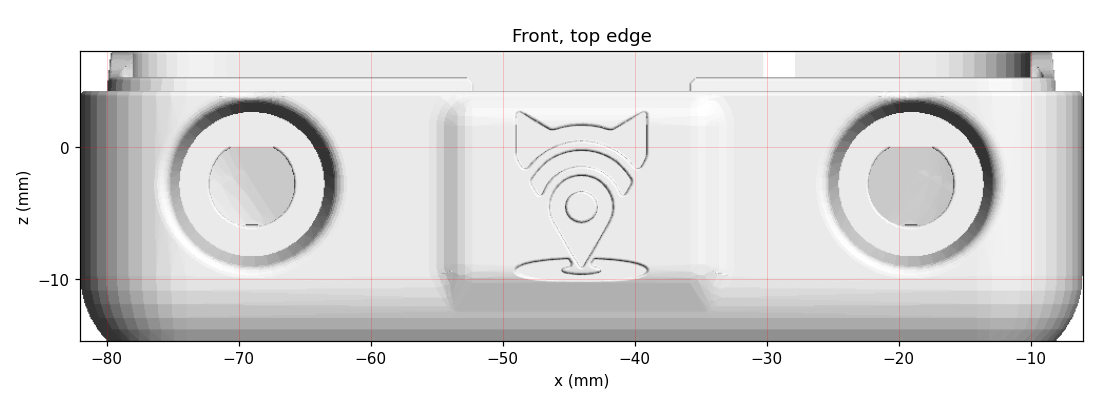
case/images/front-top-edge-sma.png
