rushikesh3982/tdeck-phone/case/images/rushiworks-case-options.png

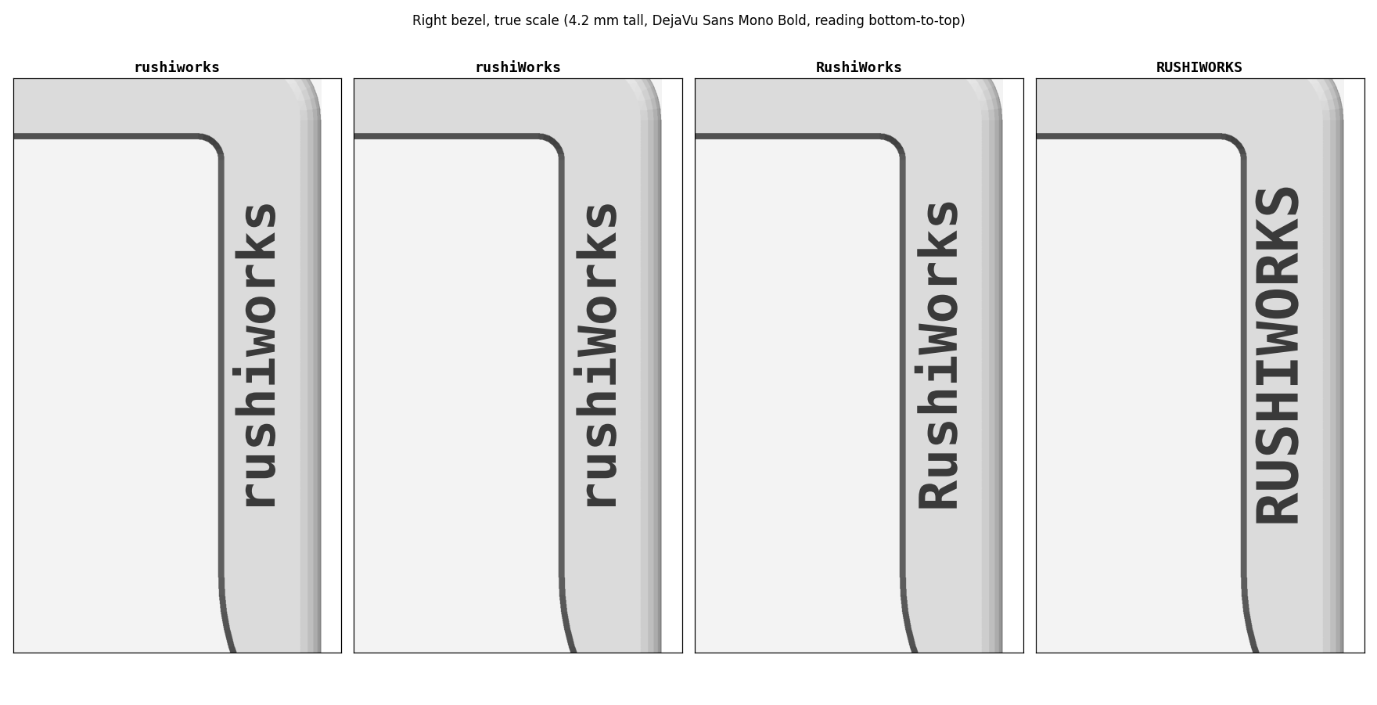
case/images/rushiworks-case-options.png
