rushikesh3982/tdeck-phone/case/images/rushiworks-font-compare.png

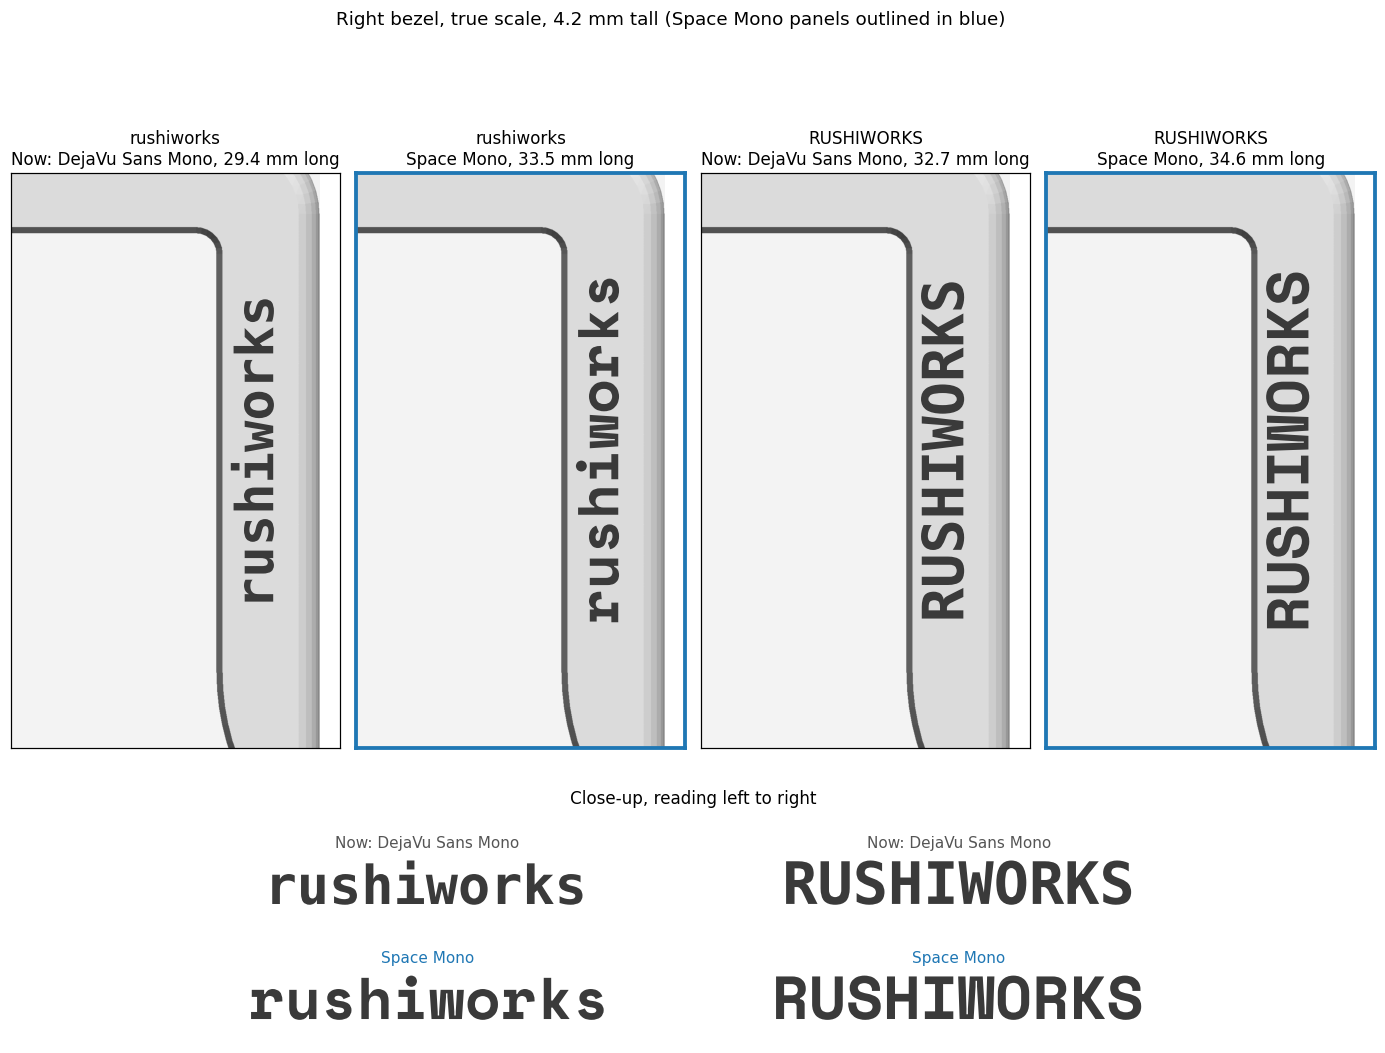
case/images/rushiworks-font-compare.png
