rushikesh3982/tdeck-phone/case/images/rushiworks-spacing-compare.png

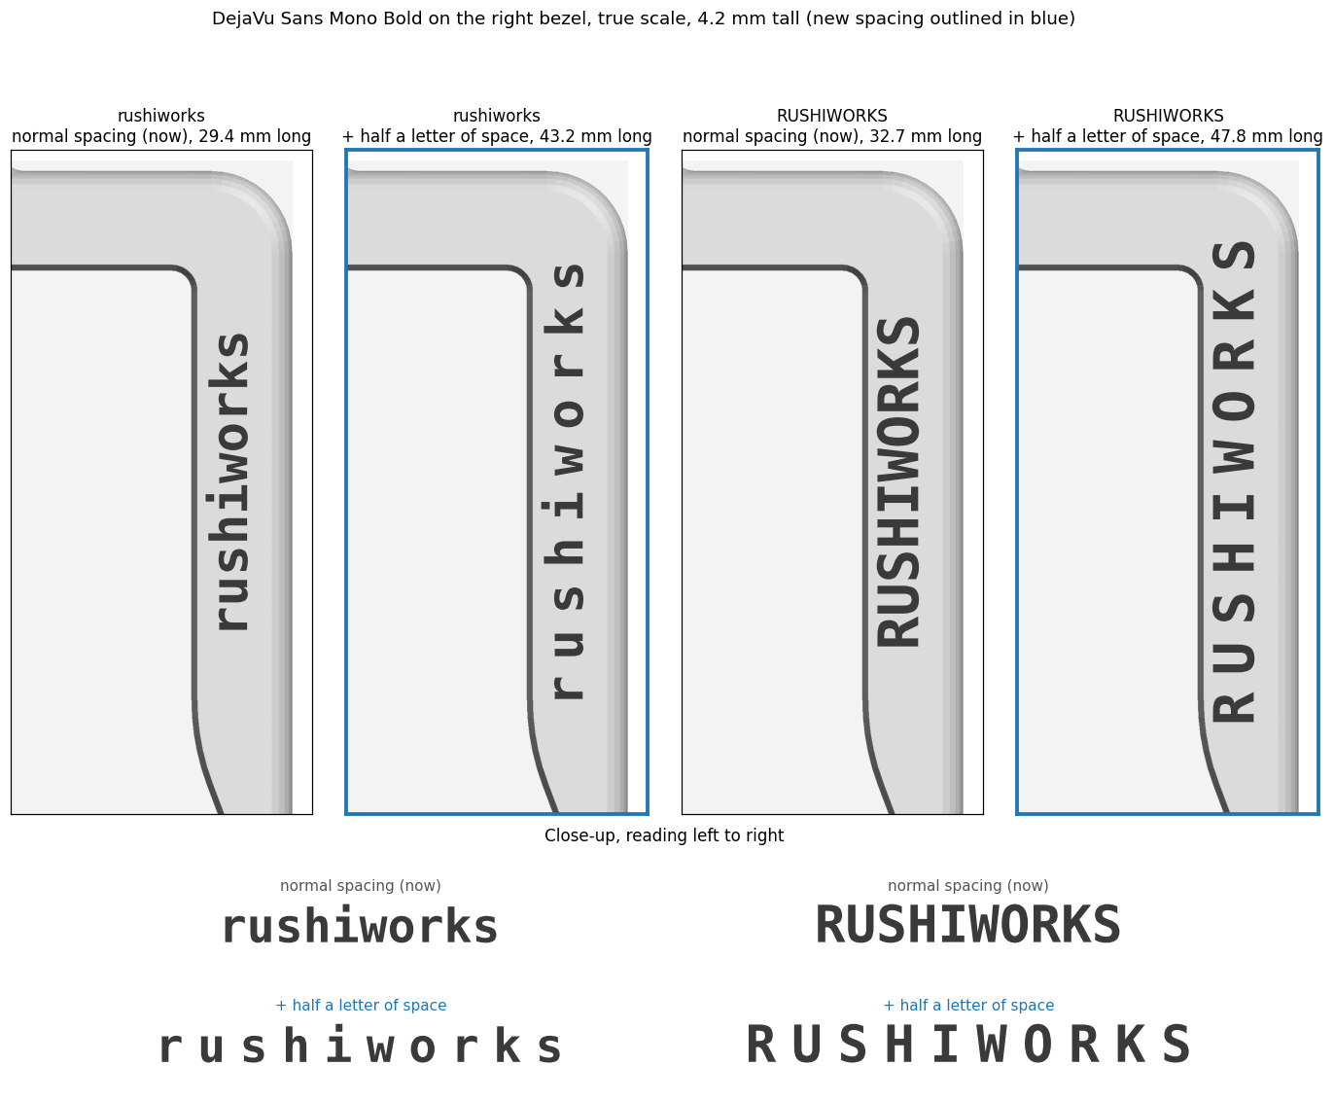
case/images/rushiworks-spacing-compare.png
