rushikesh3982/tdeck-phone/docs/images/slim-option2-front.png

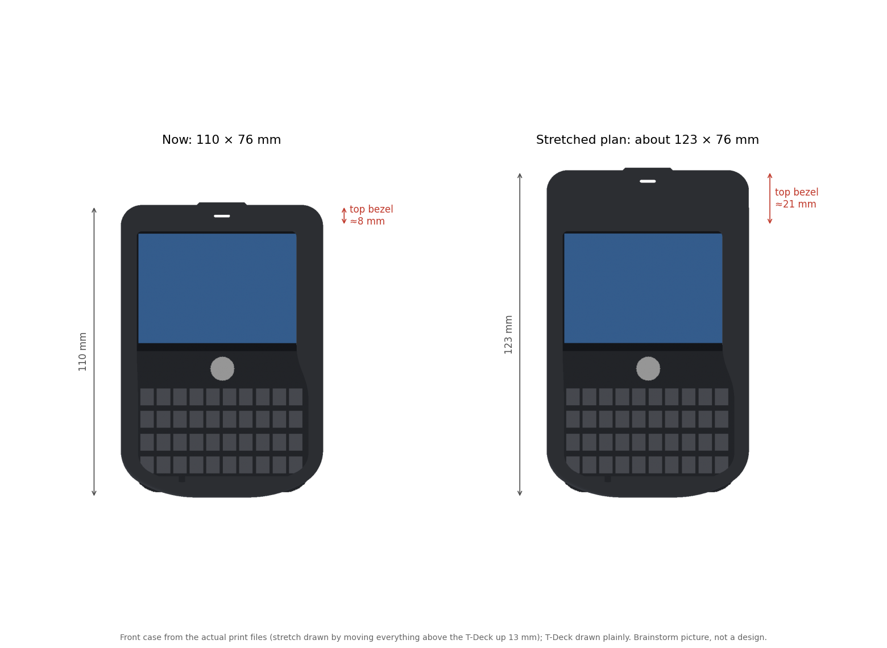
docs/images/slim-option2-front.png
