rushikesh3982/tdeck-phone/docs/images/slim-option2-layout.png

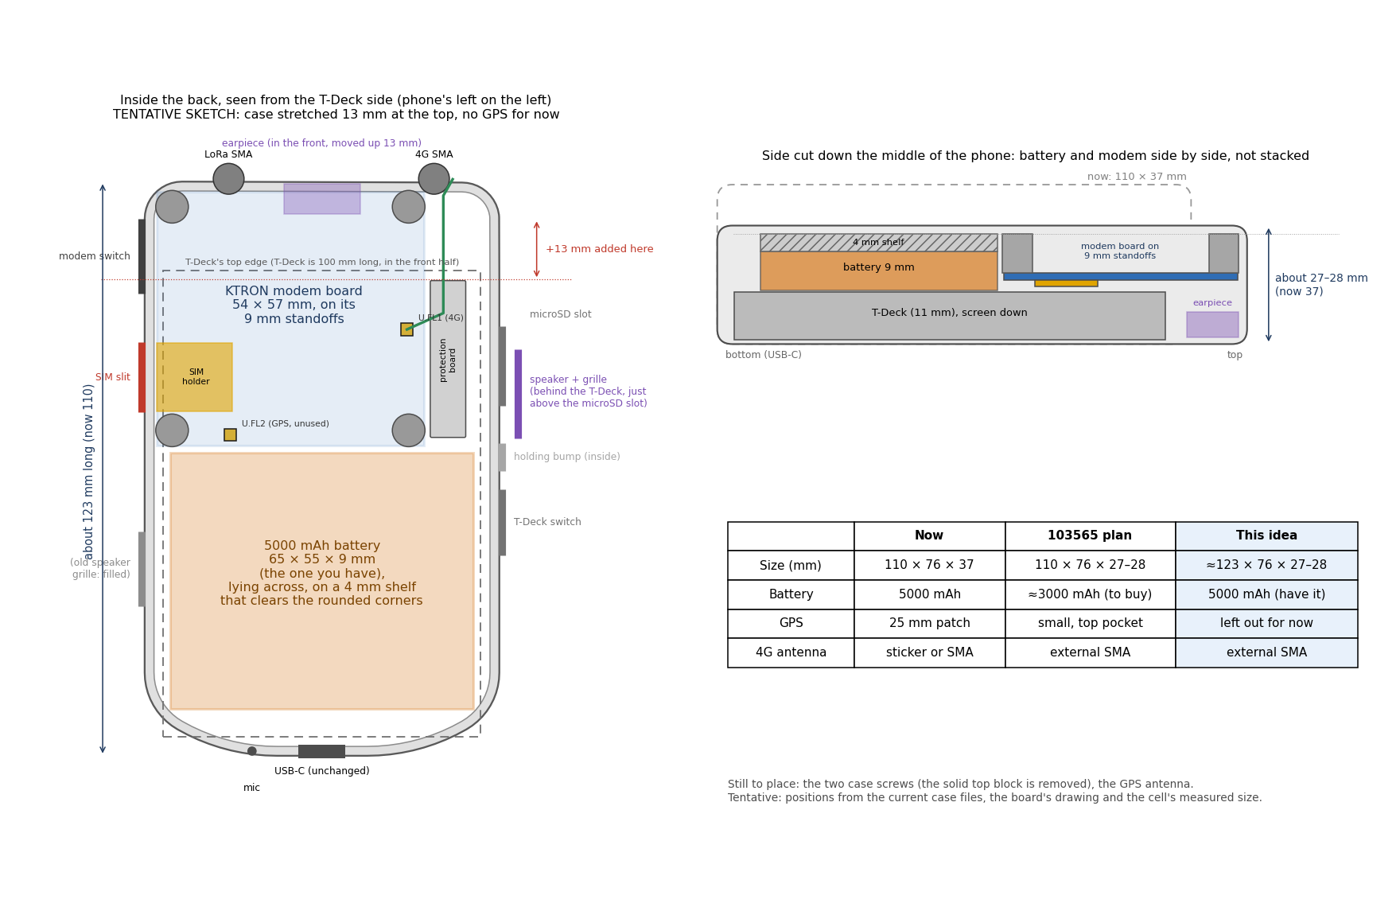
docs/images/slim-option2-layout.png
