rushikesh3982/tdeck-phone/docs/images/slim-option3-18650-grip.png

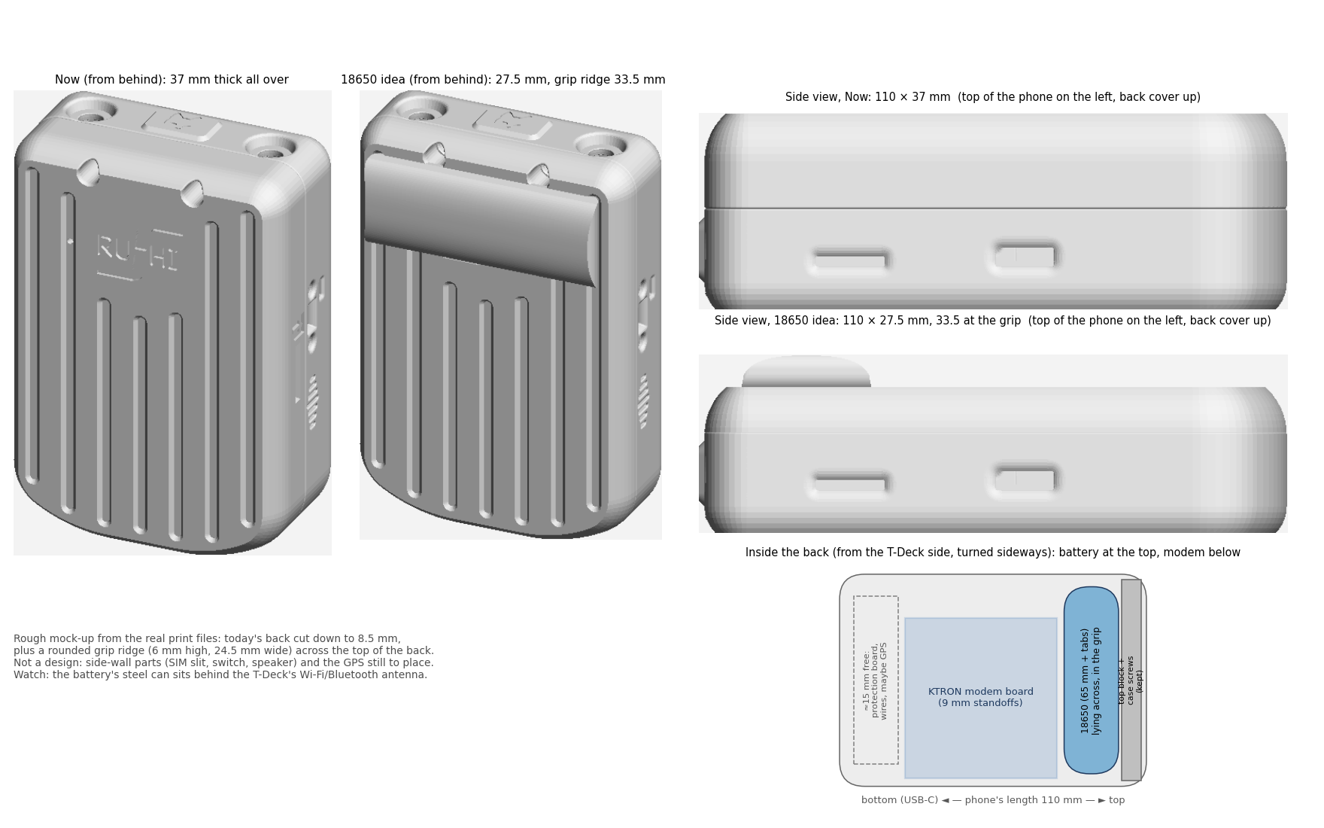
docs/images/slim-option3-18650-grip.png
