rushikesh3982/tdeck-phone/bom.md

# Bill of materials

Prices are in rupees and include GST unless noted. Status as of 12 Nov 2026.

## To order from Robu (7 Nov 2026)

| Part | Where | Notes |
|---|---|---|
| **1S Li-ion protection board, 3 A, two MOSFETs** ("1S 3.7V 3A 2MOS BMS") | [Robu](https://robu.in/product/1s-3-7v-3a-2mos-bms-li-ion-18650-battery-protection-board/) | **Received 12 Nov 2026** (two, one spare). For the bare cell. Why this one: see "Small parts" below. Cheap, so a spare is worth adding |
| **LoRa antenna: "865–868 MHz 1.8 dBi Gain Rubber Duck Antenna"** (Lambdoid LWC-868-RD-ST-SMA-PLUG-02) | [Robu](https://robu.in/product/865-868mhz-1-8-dbi-gain-rubber-duck-antenna/) | 50 × 10 mm stubby, SMA male, 865–868 MHz (India's LoRa band), **LoRa only** (no 4G). For the top-left hole, because the T-Deck's own antenna now serves 4G. **Not** Robu's "865–868 MHz 1 dBi" listing: that one is 210 mm long. Check first: the T-Deck must be the 868 MHz version, and the T-Deck's LoRa cable end must be plain SMA (a hole in the centre, not a pin) |

## 18650 version (12 Nov 2026)

Parts for the slimmer version ([docs/design-18650.md](docs/design-18650.md)). Everything else is the same as below:
the KTRON board, earpiece, mic and its 1 kΩ resistor, the SS-12F15 switch with its M2 screws, the swapped
capacitors, and the protection board above (received 12 Nov 2026, two: one spare; 32 × 4–5 mm with nickel strips).

| Part | Where | Status | Notes |
|---|---|---|---|
| **18650 cell: LG MJ1**, 3400 mAh | [Robu](https://robu.in/product/lg-18650-mj1-3400mah-3c-li-ion-battery/) | received (12 Nov 2026) | 65.2 × 18.5 mm. Genuine cells only, from a reputable seller. Replaces the 5000 mAh pouch |
| **18650 battery holder, SMD** | [Robu](https://robu.in/product/18650-battery-holder-smd-smt/) | received (12 Nov 2026) | Only its two spring contacts are used (7 × 16 mm, spring 5 mm deep), held by ribs in the case. Their solder feet are cut off |
| **GPS antenna: Eteily ET-GPL12-5L15C-U-184**, ×2 | [Eteily](https://www.eteilytechnologies.in/gps-active-ceramic-antennas.html) | ordered (quotation of 10 Nov 2026) | Active GPS/GLONASS ceramic patch, 18 × 18 × 4 mm, 15 cm cable, U.FL, 2.2–5 V. Replaces the KTRON patch. Its board is expected to be about 18.5 mm: check on arrival |
| **4G antenna, inside (try first): 41 × 12 mm flexible LTE antenna** (RESMA-41) | [Rajiv Electronics](https://rajivelectronics.com/product/4g-2-4ghz-4dbi-lte-fpc-antenna-41x12mm-8cm-cable-ufl-connector) | to order | ₹47. Sticks on, U.FL plug, 8 cm cable. Lies on the floor along the bottom, below the modem board. No datasheet: the page says only "4G LTE and 2.4 GHz", 4 dBi. Keep it only if it passes the signal test ([docs/design-18650.md](docs/design-18650.md#4g-antenna)). The full-band sticker doesn't fit inside |
| **4G antenna, outside (backup): "698–960 MHz & 1710–2690 MHz 1.2 / 2 dBi Gain Rubber Duck Antenna"** (Lambdoid LWC-4G-RD-RA-SMA-PLUG-02) | [Robu](https://robu.in/?p=1444585) | to order | 50 mm long, 10 mm across, right-angled, SMA male, VSWR under 2, covering every Indian 4G band (from its datasheet). Same maker as the LoRa stubby. Screws into the top-right SMA hole, with the KTRON IPX → SMA cable (owned) |
| 4 × M3 heat-set inserts + M3 screws | owned | owned | For the 8 mm standoffs, as now |
| 2 × M2 × 8 mm countersunk screws + nuts | any | check | For the modem switch, which sits deeper in the 18650 back: 6 mm screws are too short there |

**Not needed in the 18650 version:** the 5000 mAh pouch, the KTRON GPS patch, and the foam sheet.

## Version 1 parts (all owned now)

| # | Part | Where | Price | Status | Notes |
|---|---|---|---|---|---|
| 1 | KTRON KSTM1548: SIMCom A7672S 4G + GNSS development board | [ktron.in](https://www.ktron.in/product/sim-a7672s-4g-lte-2g-gnss-development-board/) | ₹1,530 | owned, bench-tested | 54.33 × 57.23 mm, 28 g |
| 2 | KTRON GPS active patch antenna KSTA1417 | [ktron.in](https://www.ktron.in/product/gps-antenna-with-ufl-female-connector/) | ₹105 | owned, works | 25 × 25 × ~8 mm, 4 corner holes, short u.FL lead |
| 3 | KTRON IPX → SMA female antenna cable, 10 cm | [ktron.in](https://www.ktron.in/product/rf-cable-ipx-to-sma-female-10cm-length/) | ≈₹44 | owned | 10 cm for the top-right corner (recommended). The 15 cm version ([KSTA0380](https://www.ktron.in/product/rf-cable-ipx-to-sma-female/), ₹42) if the 4G antenna goes top-left. Comes with nut and washers |
| 4 | LTE antenna, SMA male, **rated 700–2700 MHz** | any | ~₹100–200 | **not owned: fallback only** | The bench tests used the full-band sticker (below) instead. Buy one only if the sticker is too weak inside the case. The Lambdoid 50 mm stubby in the 18650 list above would do. **Not** the KTRON "4G LTE 3.5 dBi foldable": out of stock, and its own spec says 2.4–5 GHz |
| 5 | Sunrom 6027 electret microphone, 6 × 2.7 mm with pins, ×3 | [sunrom.com](https://www.sunrom.com/p/omnidirectional-electret-condenser-microphone-6x27mm-with-pins-6027-capacitive-sensitivity-60db) | ₹20.70 each | owned, with spares | Needs the 1 kΩ resistor below to work ([docs/wiring.md](docs/wiring.md), section 4) |
| 6 | Multimeter | any | ~₹250 | owned | Needed **before** soldering the battery wire to the modem board |
| 7 | Modem power switch: **SS-12F15** slide switch (owned, 4 mm knob) + 2 × M2 countersunk screws (6–8 mm) + 2 × M2 nuts | owned / any | ~₹10 | owned | Fits Alley Cat's left-side mount. Circuit in [docs/wiring.md](docs/wiring.md), section 2. The earlier two-MOSFET switch that follows the T-Deck (AO3401A + AO3400A + 2 × 100 kΩ) is documented there as an alternative, not used |
| 8 | M3 heat-set inserts (4.5 mm hole), M3 screws, M2 self-tapping screws | any | — | owned | Case closure: 2× M3×5 inserts + 2× M3×8 screws. Modem board: 4 more M3 inserts + screws. GPS patch: M2 self-tappers |

**Rough total** for items 1–7: about ₹2,100–2,200, before shipping and fasteners. The small parts below are owned too,
and the protection board has arrived.

### Small parts named in the plan

- **1S Li-ion protection board, the 3 A two-MOSFET version:** "1S 3.7V 3A 2MOS BMS" (DW01A + two 8205A in parallel),
  measured 32 × 4–5 mm with a nickel strip on each end, e.g. [Robu](https://robu.in/product/1s-3-7v-3a-2mos-bms-li-ion-18650-battery-protection-board/). The 5000 mAh cell is bare and has no protection circuit
  of its own (see [docs/wiring.md](docs/wiring.md), section 2). The two MOSFETs in parallel halve the resistance, so the
  modem's 2 A bursts drop less voltage and stay well below the overcurrent trip. The 1-MOSFET boards trip at about 3 A, and
  sooner when the battery is low. Thresholds: overcharge about 4.25 V, overdischarge about 2.3–2.5 V.

- JST GH 1.25 mm 2-pin lead for the T-Deck's battery socket (the type is on LilyGO's T-Deck pin map). Leads
  are sold wired both ways: check which wire lands on the socket's + before soldering
- 24 AWG wire for the modem's battery feed (≤10 cm), thinner wire for the data and audio wires
- Thin foam sheet (between battery and modem board)
- Filament for the case: **ASA only** (the files are built 1 % larger for ASA's shrinkage)
- Heat-shrink tubing
- 2 × 47 µF electrolytic capacitors, 10 V or more, about 4–5 mm across: one in series with each earpiece wire
  (SIMCom's and KTRON's reference circuit)
- 1 kΩ resistor, from M− to GND on the modem board: the mic gets no power without it
- For the bench tests: 10 female-to-female jumper wires, 20 cm long, one per hole (one plug cut off and soldered to
  the KTRON board, the other plug on the CP2102 or the supply), and a 5 V ≥2 A phone charger with a USB
  breakout board or a cut-open USB cable

## Already owned

| Part | Used for |
|---|---|
| LilyGO T-Deck (base model, ESP32-S3FN16R8) | The phone itself |
| Full-band LTE sticker antenna, 698–960 / 1710–2690 MHz, 110 × 20 mm, U.FL plug on an 11 cm cable (came in the T-Deck's box as its LoRa antenna) | **The 4G antenna**, on U.FL1, inside the case ([docs/wiring.md](docs/wiring.md), section 6). Used for all the bench tests. LoRa gets the stubby above instead |
| CP2102 USB-serial adapter (with 3.3 V pin) | Bench tests from the Mac before the firmware exists ([docs/bring-up.md](docs/bring-up.md)) |
| Li-ion pouch cell HH 955465, 5000 mAh, 9.5 × 54 × 65 mm nominal (measured 65 × 55 × 9), bare tabs with a JST lead. No protection circuit, so it needs a protection board (above) | Powers both boards |
| Radial electrolytics: 470 µF 16 V (6–7 × 12 mm) and 100 µF 16 V (4–5 × 8 mm) | Replace the KTRON's 11 mm tall C11 and C17, laid flat, so the board fits under the battery |
| Micromax Canvas A1, salvaged: earpiece receiver (32 Ω, from the top of the phone) | Call earpiece |
| Micromax Canvas A1, salvaged: rear loudspeaker (8 Ω) and coin vibration motor | Kept for version 2 |
| Vanix Tracx-1b (Quectel EC200U-CN) | Not used in v1. No reachable audio pins. Keep for data/GPS tests or sell |

## Fallbacks

- **Earpiece:** PUI AR01532MS (DigiKey India, ₹344 + ₹1,200 delivery), or any phone "ear speaker" that reads
  25–32 Ω, or a driver cut out of a wired earphone for bench tests.
- **Microphone:** KTRON 9 × 7 mm, ₹8.75 (https://www.ktron.in/product/microphone-9x7mm-th/); Robu pack of 3,
  ₹36 (https://robu.in/?p=699586); Sunrom HM4522P-423-G, 4.5 × 2.2 mm phone mic, for a later carrier PCB.

## Version 2 (later)

| Part | Where | Price | Notes |
|---|---|---|---|
| Speakerphone, option A: SmartElex Digital Speaker Module (8002 amp + 8 Ω speaker) | Robu | ₹189 | 40 × 40 × 14 mm, 2–5.5 V |
| Speakerphone, option B: Waveshare 2030 cavity speaker (8 Ω 2 W) + PAM8403 amp board | ThinkRobotics | ₹300 + amp | Speaker 20 × 30 × 5.5 mm |
| Buck-boost regulator set to 3.9 V (optional) | — | — | Replaces the modem board's LDO (the T-Deck MAX does this with an SGM6609) |
