rushikesh3982/tdeck-phone/case/18650/stl/back-18650.stl

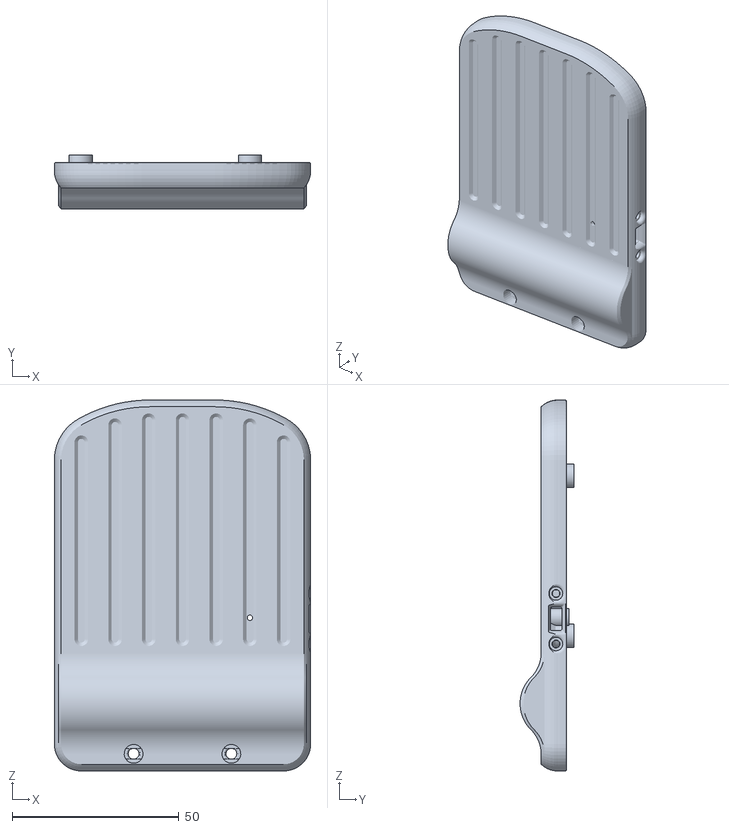
[picture p33: CAD file, 2026-11-13]
case/18650/stl/back-18650.stl
76.8 x 16.1 x 111.1
