rushikesh3982/tdeck-phone/case/stl/100/front-earpiece-mic.stl

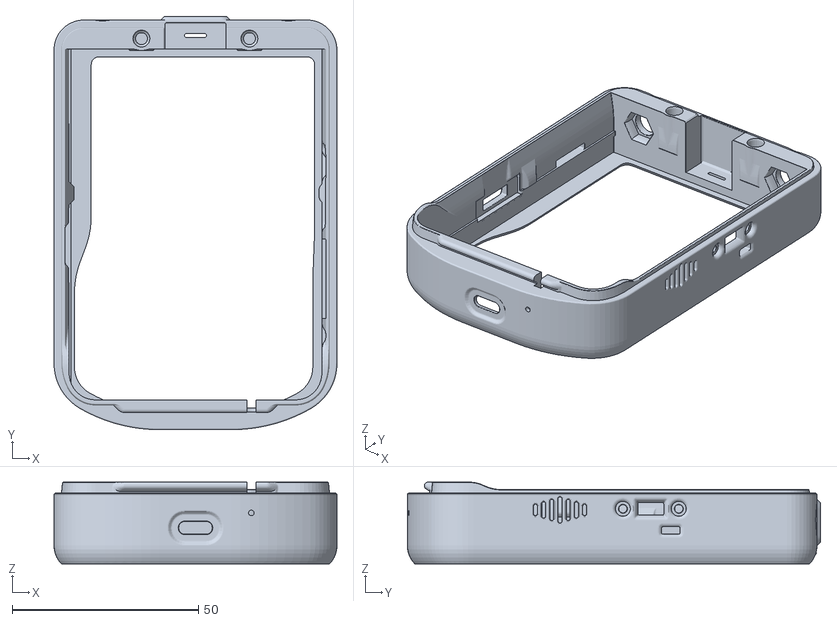
[picture p34: CAD file, 2026-11-06]
case/stl/100/front-earpiece-mic.stl
76.0 x 111.0 x 22.0
