rushikesh3982/tdeck-phone/case/stl/101/front-earpiece-mic.stl

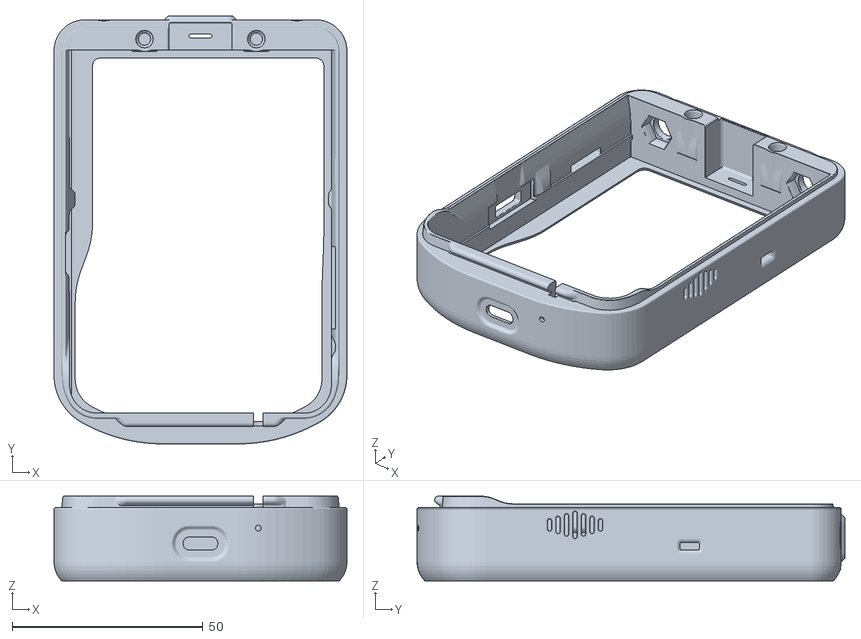
[picture p35: CAD file, 2026-11-05]
case/stl/101/front-earpiece-mic.stl
76.8 x 112.1 x 22.2
