rushikesh3982/tdeck-phone/case/stl/18650/earpiece-holder-18650.stl

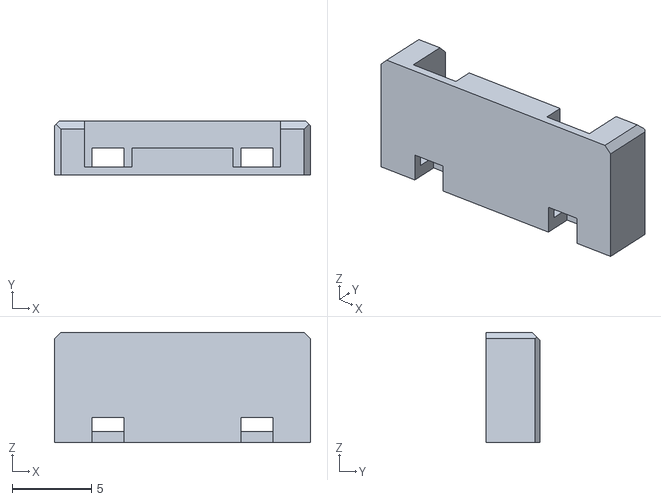
[picture p36: CAD file, 2026-11-12]
case/stl/18650/earpiece-holder-18650.stl
16.2 x 3.40 x 6.97
