rushikesh3982/tdeck-phone/case/stl/back-modem-gps.stl

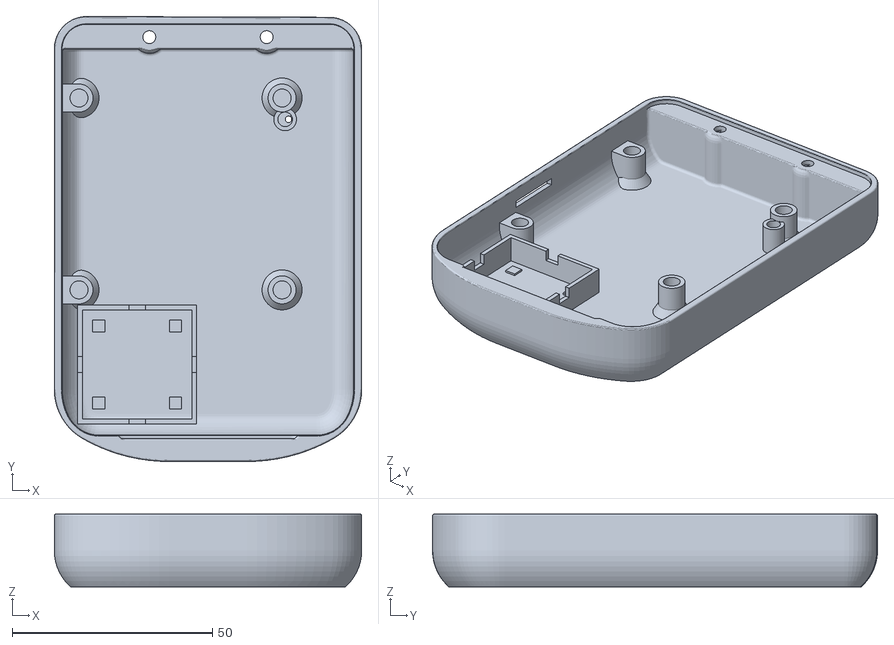
[picture p37: CAD file, 2026-11-07]
case/stl/back-modem-gps.stl
76.8 x 111.1 x 18.2
