rushikesh3982/tdeck-phone/case/stl/test-prints/test-fit-ring-100.stl

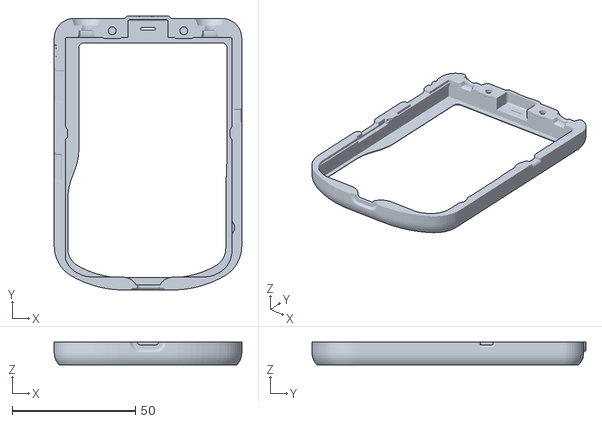
[picture p38: CAD file, 2026-11-07]
case/stl/test-prints/test-fit-ring-100.stl
76.0 x 111.0 x 9.20
