rushikesh3982/tdeck-phone/case/stl/101/alley-chat-td1-reset-button.stl

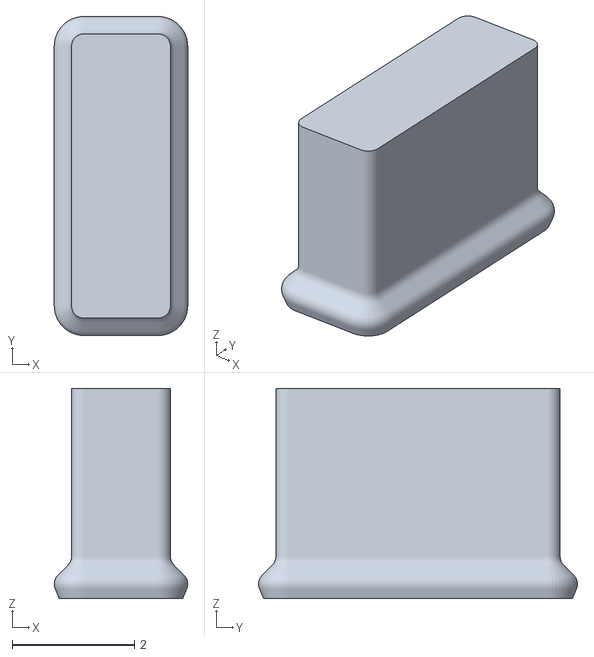
[picture p39: CAD file, 2026-11-05]
case/stl/101/alley-chat-td1-reset-button.stl
2.18 x 5.21 x 3.43
