rushikesh3982/tdeck-phone/case/stl/earpiece-holder.stl

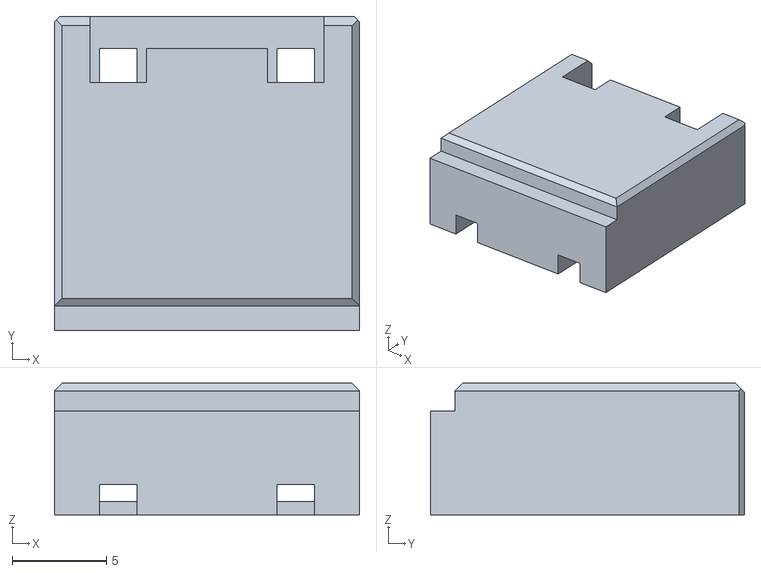
[picture p40: CAD file, 2026-11-07]
case/stl/earpiece-holder.stl
16.2 x 16.7 x 6.97
