rushikesh3982/tdeck-phone/case/stl/test-prints/test-fit-ring-101.stl

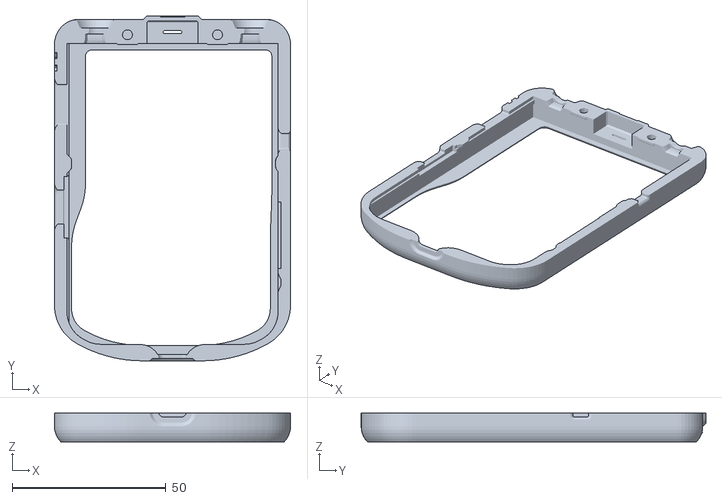
[picture p41: CAD file, 2026-11-07]
case/stl/test-prints/test-fit-ring-101.stl
76.8 x 112.1 x 9.29
