rushikesh3982/tdeck-phone/case/18650/stl/alley-chat-td1-x-antenna-plug-gsm.stl

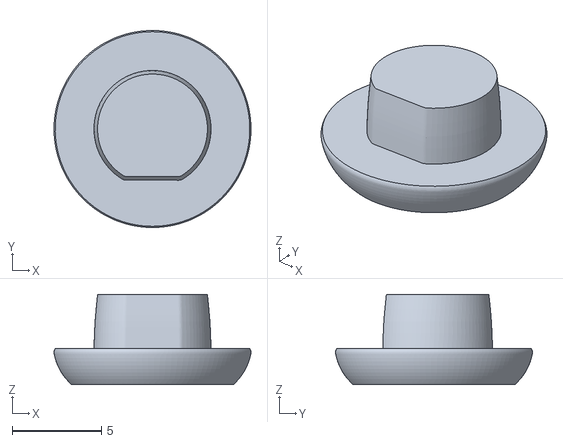
[picture p42: CAD file, 2026-11-12]
case/18650/stl/alley-chat-td1-x-antenna-plug-gsm.stl
11.0 x 11.0 x 5.05
