rushikesh3982/tdeck-phone/case/stl/test-prints/test-mic-coupon.stl

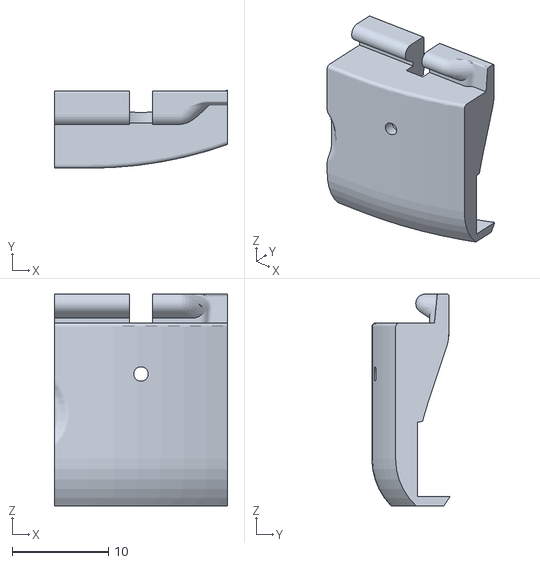
[picture p43: CAD file, 2026-11-05]
case/stl/test-prints/test-mic-coupon.stl
18.0 x 8.13 x 22.0
