rushikesh3982/tdeck-phone/case/18650/stl/alley-chat-td1-switch.stl

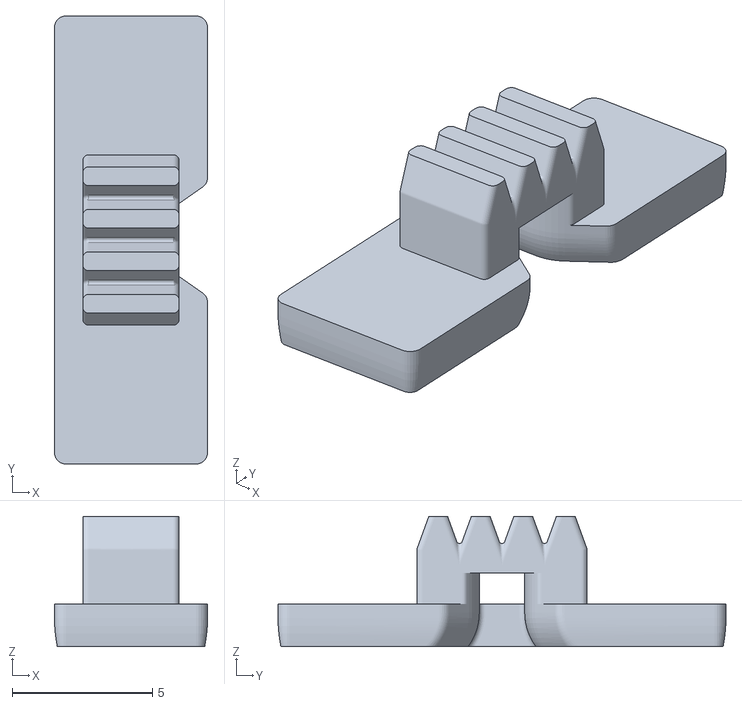
[picture p44: CAD file, 2026-11-12]
case/18650/stl/alley-chat-td1-switch.stl
5.45 x 16.0 x 4.65
