rushikesh3982/tdeck-phone/case/stl/alley-chat-td1-x-antenna-plug.stl

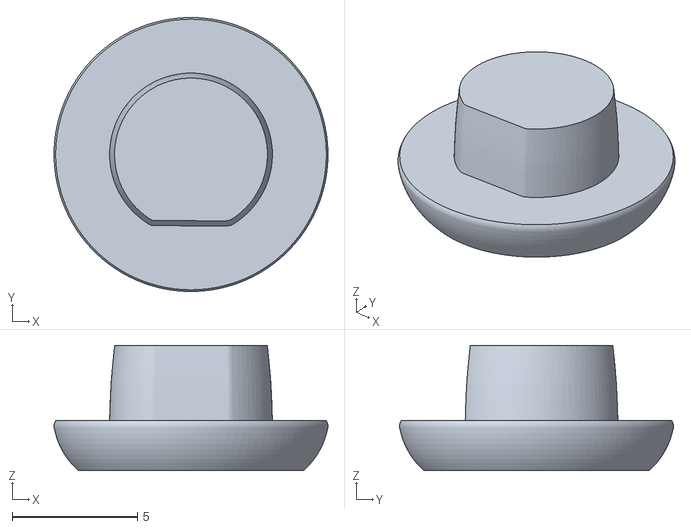
[picture p45: CAD file, 2026-11-05]
case/stl/alley-chat-td1-x-antenna-plug.stl
10.9 x 10.9 x 5.00
