rushikesh3982/tdeck-phone/(list of files, cad)

Other CAD files:
case/test-fit-ring-100.stl
case/x-back-5000mah/stl/front-earpiece-mic.stl
case/18650/stl/front-18650.stl
case/test-fit-ring-101.stl
case/stl/front-earpiece-mic.stl
case/back-modem-gps.stl
case/earpiece-holder.stl
case/front-earpiece-mic.stl
case/stl/18650/back-18650.stl
case/stl/18650/front-18650.stl
