rushikesh3982/tdeck-phone/case/images/assembly-back-inside.png

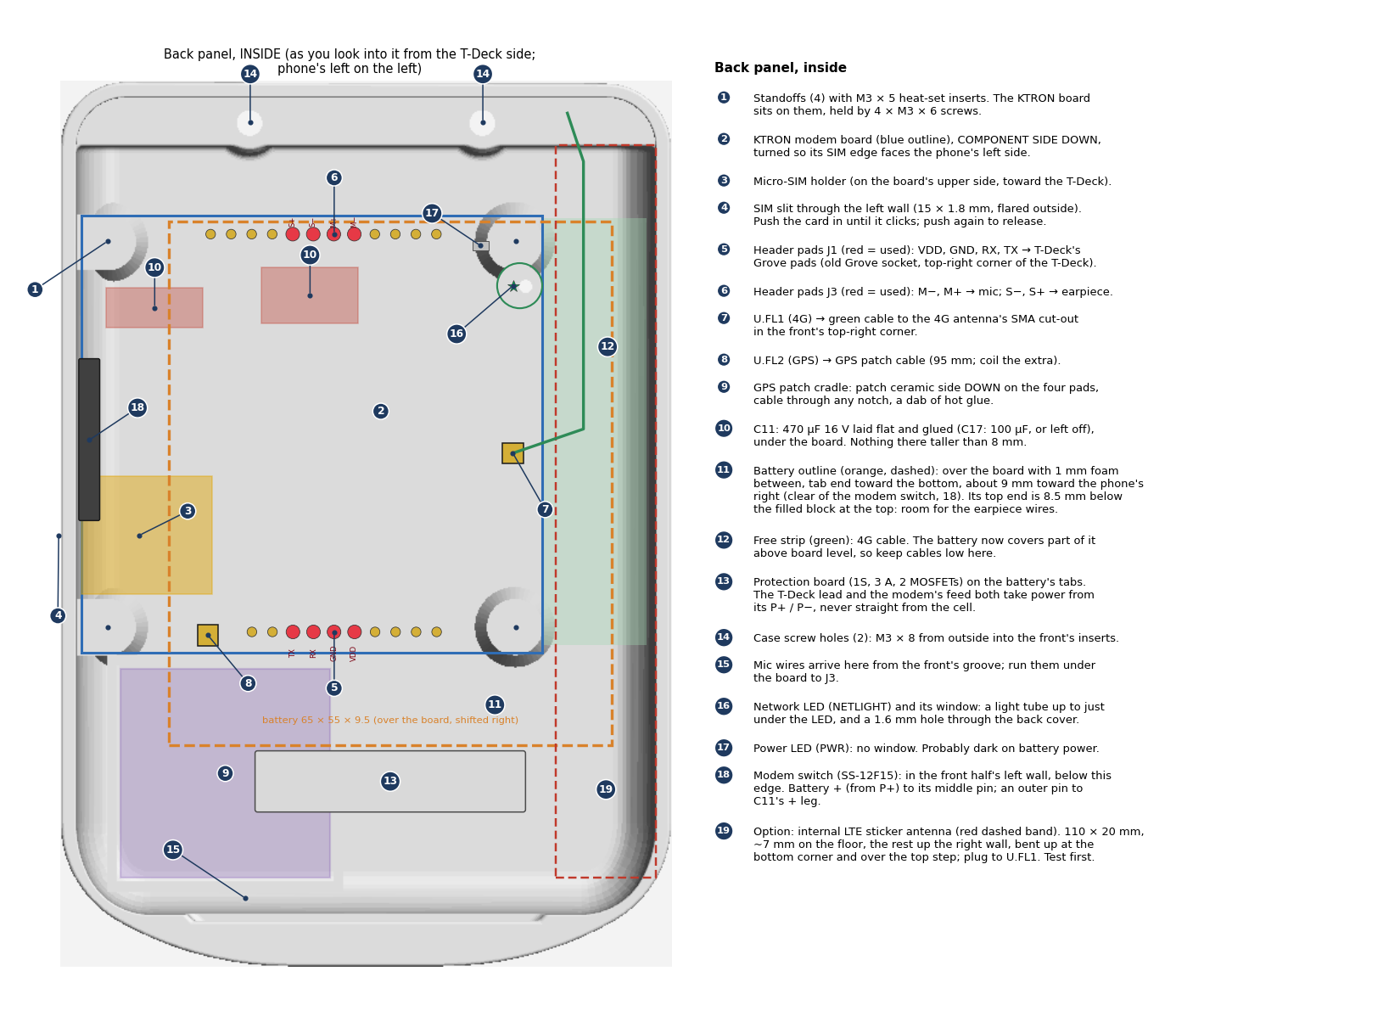
case/images/assembly-back-inside.png
