rushikesh3982/tdeck-phone/case/images/assembly-stack.png

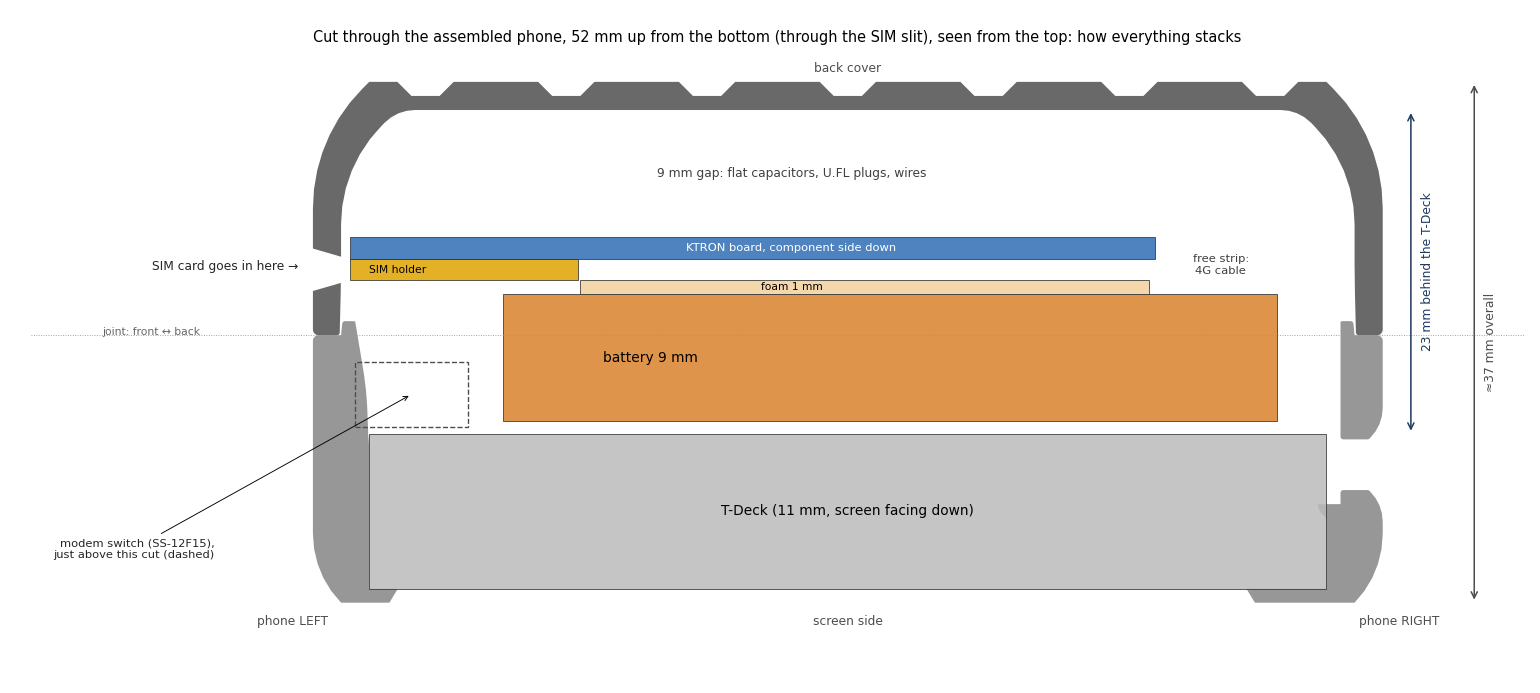
case/images/assembly-stack.png
