rushikesh3982/tdeck-phone/docs/build-log.md

# Build log

The hardware as it was really built, step by step, with photos. The other docs explain the design and the reasons
for it. This page shows what was done and what it looked like. The newest step is at the bottom.

Each photo is shown on a white background, with its parts labelled. Before it goes in, its hidden data (location,
date, camera) is removed, and the modem's serial number, IMEI and QR code are blurred: the IMEI is the modem's
identity on the mobile network. Its make and model (SIMCom A7672S) and part number stay readable (see
[Adding photos](#adding-photos)).

## 1. Modem board: the tall capacitors swapped (4 Nov 2026)

**Why:** the KTRON board came with two capacitors 11 mm tall, too tall for the case. In the current build the board
sits under the 9 mm battery, and in the 18650 version on 8 mm standoffs. Radial capacitors laid flat take about
7 mm ([decisions.md](decisions.md#ktrons-tall-capacitors-swapped-for-radial-ones-laid-flat-decided-3-nov-2026)).

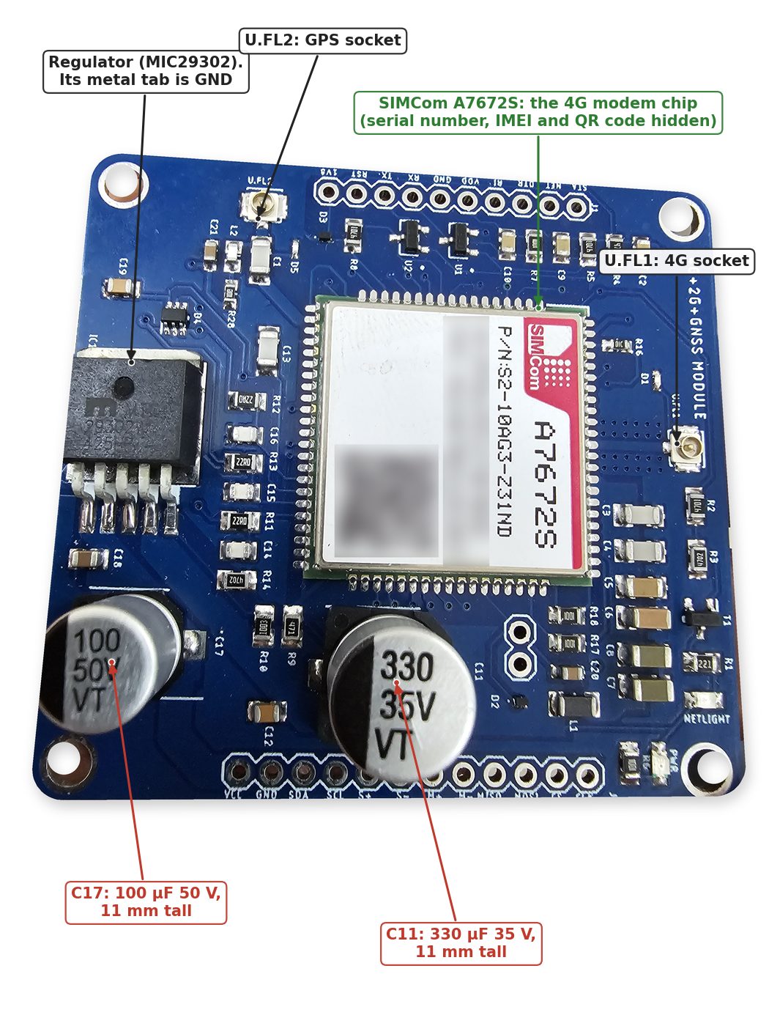
[picture p53: docs/images/build-log/01-modem-board-as-received.jpg]
The KTRON board as it arrived, with its two tall capacitors, regulator and antenna sockets labelled


**As it arrived:** C17 (100 µF 50 V) and C11 (330 µF 35 V), both 11 mm tall. The photo also shows parts named in the
other docs: the regulator, whose metal tab is the modem's GND point for the battery, and the two antenna sockets.

<p align="center">
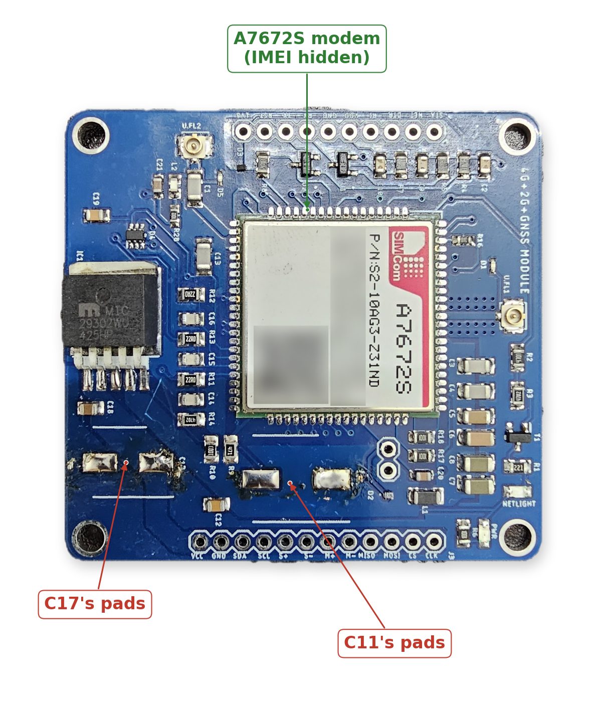
[picture p54: docs/images/build-log/02-tall-capacitors-removed.jpg]
Both tall capacitors removed, their pads cleaned
  
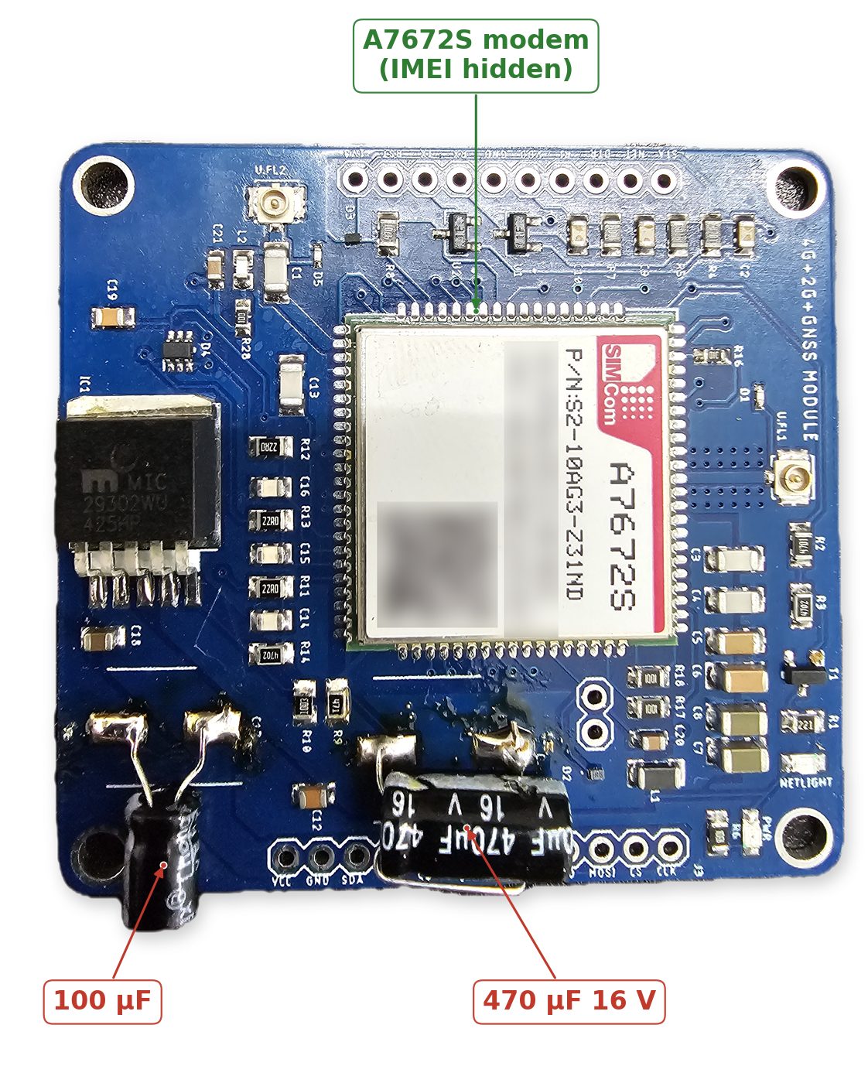
[picture p55: docs/images/build-log/03-capacitors-laid-flat.jpg]
The new capacitors soldered on the old pads, lying flat
  
</p>

**Taken off, then replaced:** both old capacitors came off their pads (left). A 470 µF 16 V went on C11's pads and a
100 µF 16 V on C17's, each on bent legs, lying flat (right).

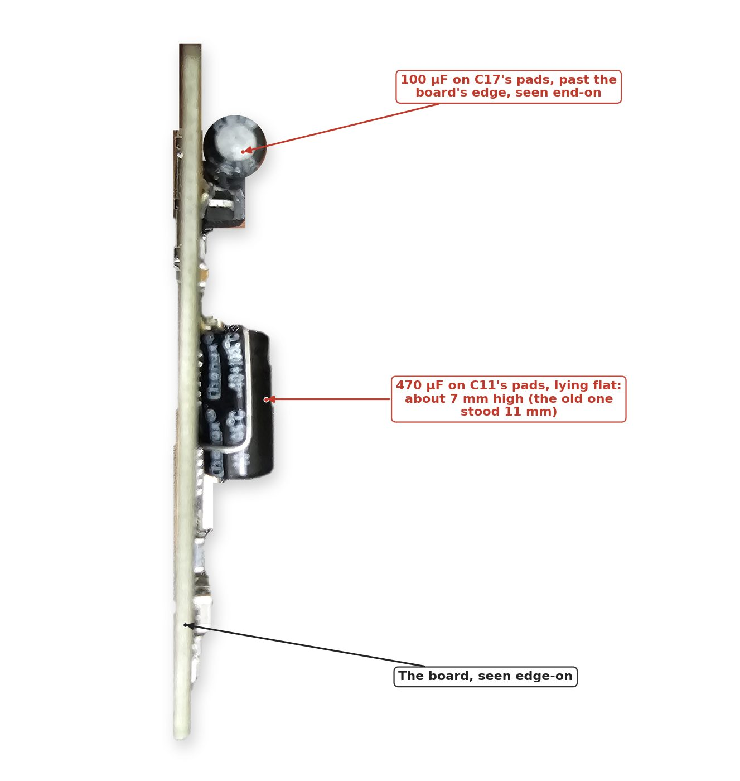
[picture p56: docs/images/build-log/04-capacitors-side-view.jpg]
Side view: the board edge-on, with both new capacitors lying flat


**Height:** about 7 mm instead of 11.

**Checked on 5 Nov 2026,** with 5 V on the bench: both capacitors are the right way round. C11's + leg reads 3.86 V
and C17's 4.97 V, so C17 is on the VCC input ([bring-up.md](bring-up.md#bench-results-so-far-5-nov-2026-no-sim-no-antenna-5-v-on-vcc)).

## 2. Bench tests of the modem (5–11 Nov 2026)

**Setup:** the modem board on its own, talking to the Mac through the CP2102 USB-serial adapter, powered from 5 V
on VCC. Wired as in [bring-up.md](bring-up.md#phase-a-the-10-holes-to-solder) and its
[bench wiring picture](images/bench-wiring.png). Photographed on 12 Nov 2026.

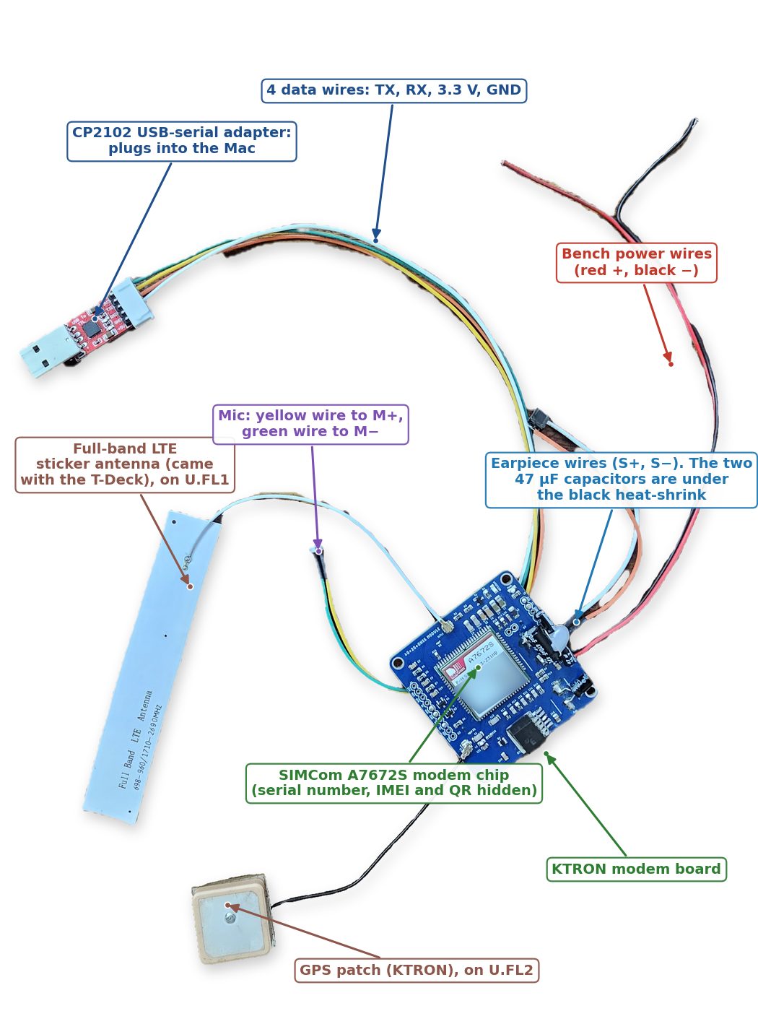
[picture p57: docs/images/build-log/05-bench-setup-component-side.jpg]
The bench setup, the modem board's component side up


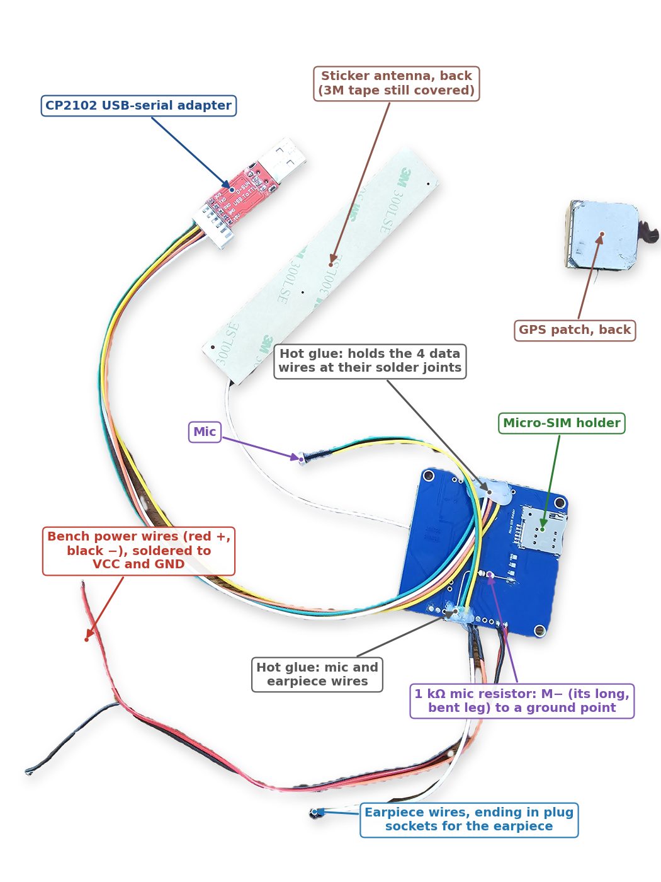
[picture p58: docs/images/build-log/06-bench-setup-sim-side.jpg]
The same setup turned over: the SIM-card side, with the hot glue and the mic's resistor


**What it proved** (details in [bring-up.md](bring-up.md#results-with-a-jio-sim-7-nov-2026-the-full-band-sticker-antenna-on-ufl1-in-the-open-5-v-on-vcc)):
- **5 Nov:** the modem answers, once TX and RX go straight across (not crossed). The earpiece plays sound, and GPS
  gets a fix through a window.
- **7 Nov,** with a Jio SIM: registers on 4G with VoLTE. Calls work both ways, and so do text messages.
- **11 Nov:** the mic works in a call, once the 1 kΩ resistor from M− to ground was added. The mic in the photos is
  the replacement, on new wires: yellow to M+ and green to M−.

## 3. Next: wiring the T-Deck

Photos to come once the printed parts are ready: the four data wires soldered to the T-Deck's Grove pads.

## 4. Next: assembly in the printed case

Photos to come: the parts going into the printed 18650 back and front.

## Adding photos

1. Take the photos with your phone and leave them in Downloads.
2. Ask Claude to add the latest ones to this page, and say what each step was.
3. Each photo is then turned the right way up, lifted off its background with the Mac's own "lift subject"
   feature, put on white, shrunk, labelled, and saved without its hidden data (location, date, camera). The modem's
   serial number, IMEI and QR code are blurred. The labels and any hand-traced fixes for every photo are listed in
   [docs/scripts/make_build_log_photos.py](scripts/make_build_log_photos.py), so they can be changed and the photos
   made again.
4. **Photos that come out best:** the parts on a plain surface that contrasts with them (a white sheet of paper
   suits dark and coloured parts), lit evenly, with no hand in the frame. Thin black wires on a dark table are the
   hardest to lift cleanly.

**Keep out of the photos:** the SIM card's number, phone numbers on a screen, and anything that shows where you live.
