rushikesh3982/tdeck-phone/(commit log)

2026-11-02 Seed the project docs from the design handoff
    README, parts list, wiring, bring-up checks, case changes and the
    decision log for the T-Deck phone (A7672S modem, India VoLTE).
2026-11-02 Add MIT licence
    Case files modified from Alley Cat's design stay CC BY-SA 4.0, noted in
    the README.
2026-11-02 Name the owned USB-serial adapter: CP2102 with a 3.3 V pin
2026-11-02 Draw the modem power switch circuit
    AO3401A high-side switch with a 100 kOhm gate pull-up and a small slide
    switch to ground. Adds why the switch is needed, build notes and
    multimeter checks; parts list and decision log updated to match.
2026-11-02 Split bench tests into a no-solder phase and a battery phase
    KTRON's page gives VCC as 5-12 V DC, so the first tests (serial, SIM,
    network, VoLTE call, SMS, GNSS) run on the stock headers with jumper
    wires and a 5 V supply. The board stays returnable until those pass;
    header removal and the battery feed move to phase B.
2026-11-03 Bench tests for a KTRON board that arrives without pin headers
    The board ships with empty holes, so phase A solders wires into only the
    10 holes the phone needs (the same wires the phone keeps), powers it
    from 5 V on VCC, and adds a VCC-GND short check before power-on. Phase B
    now removes the bench power wires instead of desoldering headers.
2026-11-03 Front case: earpiece grille and bottom-left mic pocket
    Adds case/front-earpiece-mic.stl, made from Alley Cat's TD1 Standard
    Front GPS Inserts (CC BY-SA 4.0) by case/scripts/make_front.py:
    - 1 x 6 mm slot through the face under the GPS pocket for the earpiece
    - 6.3 mm teardrop mic pocket left of USB-C, 1.2 mm skin, 1.5 mm sound
    hole, wire groove through the mating lip
    Also a small mic test coupon, previews, and case/README with credits.
    Corrects the notes: the front has no slide-switch pocket (Switch.stl is
    the T-Deck power-switch slider), so the modem switch is placed with the
    back.
2026-11-03 Modem follows the T-Deck's power switch; note mic fitting order
    Replace the separate slide switch with an AO3400A driven by the Grove
    3.3 V (already wired to KTRON VDD, on only while the T-Deck is on with
    GPIO10 high), which turns on the AO3401A in the modem battery feed. No
    switch pocket needed in the case. Parts list, decisions and case notes
    updated. Case README now says the mic goes in before the T-Deck.
2026-11-03 Draft back panel: KTRON standoffs and GPS patch cradle
    case/back-modem-gps.stl (draft, not for printing yet), made from the TD1
    X back by case/scripts/make_back.py:
    - four 14 mm standoffs with M3 heat-set insert holes at the KTRON holes
    (47.90 x 50.70 mm), board component side down, SIM edge to the left
    - 25.6 mm GPS patch cradle with corner ledges and cable notches
    Layout and preview images added. SIM slit waits for measurements.
    Corrections: KTRON board is 54.33 x 57.23 mm; the GPS front does have a
    left-side slide-switch mount (unused now).
2026-11-03 Back panel v1: 9 mm standoffs, SIM slit, measured GPS cradle
    - Standoffs drop to 9 mm: the KTRON's 11 mm SMD capacitors (C11, C17)
    are replaced by owned 470 uF / 100 uF 16 V radials laid flat, so the
    9 mm battery fits (stack 22.1 of 23 mm). Left columns fused to the wall.
    - SIM slit in the left wall, 15 x 1.8 mm flaring to ~16 x 3 mm, fully in
    the back panel 4.65 mm below the rim (standard 1.5 mm push-push holder).
    - GPS cradle resized for the measured 26 mm patch: 27 mm opening, 7 mm
    fence, ceramic on four 0.5 mm pads, cable notches on every side.
    Docs: capacitor swap step in bring-up phase B, decision entry, battery
    size 65 x 55 x 9 mm, C11 replaces "330 uF" in wiring.
    Co-Authored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
2026-11-03 Front: second SMA antenna cut-out in the old Grove corner
    The Grove socket is desoldered and the modem wires go to its pads, so
    the Grove plug slot is filled and the top-right corner gets an exact
    mirror (x = -88 - x) of the case's own top-left SMA cut-out: 6.56 mm
    hole, 2 mm wall, 8.4 mm hex pocket, 12 mm nut recess. Checked against
    the KTRON IPX to SMA-female cable (KSTA0380): thread, hex collar and nut
    all fit. Docs: fit table, T-Deck clearance check, corner recommendation
    (4G top-right, LoRa stays top-left), Grove removal in wiring.
2026-11-03 Assembly diagrams and step-by-step assembly page
    Four diagrams drawn from the case files by case/scripts/make_diagrams.py:
    front outside (unfolded, every opening numbered), front inside (pockets,
    hex pockets, inserts), back inside (board, SIM, used header pads, U.FL
    cables, GPS cradle, capacitors, battery, free strip, MOSFET board) and a
    cut through the assembled phone showing the stack. docs/assembly.md
    walks through inserts, wiring, front, back, closing and first checks.
2026-11-03 Fill the unused slide-switch mount on the front's left side
    The GPS version's switch window and two countersunk screw holes are
    filled flush with the outside through the 2.6 mm wall (the modem follows
    the T-Deck's power switch, so the mount isn't used). The inside recess
    and the Reset Button opening below stay. Front-outside diagram drops the
    switch callout and is renumbered 1-10; assembly steps and notes updated.
2026-11-03 Fill the switch mount's inside recess as well
    The unused slide-switch mount is now filled completely: the wall's normal
    cross-section (taken at y = 77, beside the mount) is copied across
    y = 51.0-75.6, replacing the outer-only fill. Kept clear: the Reset Button
    opening and its small inside flange recess (z below -3.4). Diagrams
    re-rendered; case notes updated.
2026-11-03 Back: window for the modem's network LED
    KTRON's NETLIGHT LED (component side, facing the back cover 9 mm away)
    gets a printed light tube (3.6 mm bore, up to 1.6 mm under the board)
    and a 1.6 mm hole through the cover, on the flat floor of the decorative
    groove beside it. No window for the power LED.
    Docs: SIMCom's NETLIGHT pattern (steady = searching, 200/200 ms =
    registered), PWR LED check on battery (remove R6 if lit), optional R1
    220 -> 1 kOhm to cut the network LED's ~2-4 mA average; the A76XX AT
    manual has no command to turn it off. Diagrams and previews updated.
2026-11-03 Logo placement mockup for discussion
    True-scale mockup of three places for the rushiWorks logo on the front:
    A top-left and B top-right of the earpiece slot (5 mm tall max), and C
    the top-edge badge (9 mm tall) in place of the cat + GPS-pin art.
2026-11-03 Logo mockup: traced 512 px logo, corrected stroke widths
    Redrawn from rushi-site-icon-insta.jpg (vector trace). At 5 mm beside the
    earpiece the letter strokes are only 0.24 mm, too thin for a 0.4 mm
    nozzle; the top-edge badge takes the logo at 10.8 mm (strokes ~0.53 mm).
2026-11-03 Front: rushiWorks logo badge on the top edge
    Alley Cat's raised cat + GPS-pin badge is removed (the top wall under it
    restored from its plain profile, sampled beside the badge; matches to
    ~0.001 mm) and replaced by a fresh 1 mm badge with 45-degree bevels and
    a 16.8 x 10.5 mm face, with the rushiWorks logo engraved 0.45 mm deep,
    10 mm tall, traced from case/logo/rushi-logo.jpg (reads normally from
    above with the screen toward you).
    Diagrams show the engraved logo (depth-shaded on the top edge); new
    front-top-edge.png replaces the SMA-only picture; the options mockup is
    removed now the placement is chosen. README: the rushiWorks name and
    logo are excluded from the MIT licence, and CC BY-SA g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
2026-11-03 Back: Outside Cat groove layout with the rushiWorks logo
    The back is now built from Alley Cat's X Back Outside Cat edition (same
    inside as the Inside Cat edition, verified identical above the outer
    1 mm; middle grooves shortened outside). Its engraved cat head is filled
    flush (clear of the two case-screw countersinks) and the rushiWorks logo
    is engraved 1 mm deep in its place, 32 x 22 mm, reading normally from
    behind. All inside features unchanged. Docs, previews and rebuild
    commands updated; licence note covers the logo on the back too.
2026-11-03 Credit Alley Cat on the front badge; clear the back's inside floor
    - Front: the top-edge badge is Alley Cat's original cat + GPS-pin art
    again, untouched (verified identical to their file). The rushiWorks
    logo stays only on the back cover's outside.
    - Back: Alley Cat's engraved cat head and "Alley Chat TD1 X" text on the
    inside floor are filled flat (applied before the LED window, so its
    hole still goes through).
    - make_front no longer needs the logo; trace_logo moved to make_back.
    Diagrams, previews, case notes, README credits and licence note
    updated.
2026-11-03 Candidate Alley Cat logo for the front badge (preview)
    Alley Cat's filled cat-head logo, extracted from the TD1 X back's own
    files (CC BY-SA 4.0), shown full size and at badge size (9.6 mm).
2026-11-03 Front badge: Alley Cat's cat-head logo, HT Pocket style
    The top-edge badge now carries Alley Cat's cat-head logo instead of the
    cat + GPS-pin art: a fresh badge of the original footprint (old one
    removed, wall restored from its plain profile), with the cat head
    recessed 0.35 mm and the closed eyes and nose 0.7 mm, 9.4 mm tall,
    reading upright with the phone screen-up.
    The art comes from the TD1 X back's own inner-floor engraving (CC BY-SA
    4.0, Alley Cat and Majestic AV, LLC), cheeks smoothed to match the cat
    on her Alley Chat HT Pocket case; saved as case/logo/alley-cat-head.json
    with an SVG preview and a case/logo/README covering both logos'
    licences. Diagrams and docs updated.
    Co-Authore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
2026-11-03 Back logo size comparison (32 / 24 / 20 mm) for discussion
2026-11-03 Back logo down to 24 x 17 mm
    The rushiWorks logo on the back cover is reduced from 32 x 22 mm to
    24 x 17 mm (same centre, 1 mm deep, strokes ~0.8 mm), leaving even space
    to the grooves. Inside unchanged. Previews and notes updated; the size
    comparison image is removed now the size is chosen.
2026-11-03 Front: "rushiworks" along the right bezel
    Engraved on the screen side beside the screen, reading bottom-to-top
    (tops of the letters toward the screen), DejaVu Sans Mono Bold, 4.2 mm
    tall x 29 mm. The bezel there is a 1 mm lip on the T-Deck's front, so it
    is cut 0.3 mm deep (0.7 mm stays). Front diagram callout 11, a close-up
    picture, and case notes added.
2026-11-03 Mockup: current font vs Space Mono, small letters and capitals
2026-11-04 Earpiece holder; fill the back's half of the old GPS-module slot
    - New part case/earpiece-holder.stl (16.0 x 6.9 x 16.5 mm), made by
    scripts/make_earpiece_holder.py. It fills the front's pocket and holds the
    12-13 x 5 x 2 mm receiver in a 1.7 mm cup over the grille slot (0.3 mm gasket
    squeeze). It has a wire channel and a groove up the T-Deck side, and prints on
    its groove face. The script checks it clears both case halves.
    - Back: the slot's back half (16.4 x 6.1 x 10 mm) is filled by copying the
    block's cross-section from beside it, so the block caps the holder 0.1 mm
    above its top.
    - Docs, front-inside callout and back pictures updated.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
2026-11-04 Earpiece holder: room for the folded contacts (3 mm earpiece)
    The owner's photos show the receiver's two spring contacts at the short ends of
    its back. Folded over, they add 1 mm (3 mm total). The holder now presses only
    on the middle of the back (1.7 mm, 0.3 mm gasket squeeze). Its last 3 mm at each
    end is 3.5 mm deep for the contacts and solder joints, and a 2 mm wire path
    along the T-Deck side links both ends to the groove. It still clears both case
    halves.
2026-11-04 Earpiece holder for a 12 x 6 mm receiver
    A 6 mm receiver leaves no room for walls on both sides inside the 6.9 mm
    holder. The 12.4 mm cup now has a 0.7 mm wall on the T-Deck side only; on the
    far side the pocket's own wall holds the receiver (6.4 mm of room). Each end
    pocket for the folded contacts has its own 2 mm wire groove up the T-Deck-side
    face. It prints on that face with no supports and still clears both case halves.
2026-11-04 Mic: Sunrom 6027 datasheet details, pin orientation and polarity
    The datasheet gives a 6.0 +-0.2 x 2.7 +-0.2 mm body and two 2.8 mm pins,
    1.9 mm apart. The 6.3 mm pocket fits. The pocket is open behind the mic;
    only the T-Deck's back edge reaches 1.3 mm up its screen-side edge. So the
    docs now say to set the pins side by side at centre height, trim them to
    about 1.5 mm and bend the wires up the groove. They also mark the polarity
    (ringed pin to M+, can pin to M-) and note the listed -60 dB sensitivity
    (more mic gain may be needed).
2026-11-04 Fit test rings and notes on scaling
    The front's inside is exactly the T-Deck's 68.00 mm width for 5 mm above the
    screen face, then a ridge narrows it to 67.4-67.5 mm to snap the T-Deck in, so
    fit depends on the printer and filament. Printables comments: most fit at
    100 % in PETG/PLA/ABS, ASA needed +0.5-1 %, one 102 % print needed a shim, and
    it doesn't fit the T-Deck Plus.
    - scripts/make_fit_test.py cuts a 9 mm ring (screen frame, walls, snap ridge)
    from the front, at 100 % and 101 %.
    - The docs say: test the ring first, and never scale the finished files in the
    slicer (at 101 % the modem standoffs move 0.5 mm off the board's holes).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
2026-11-04 Bench wiring diagram; earpiece capacitors; no-SIM audio tests; gain commands
    - docs/images/bench-wiring.png (docs/scripts/make_bench_wiring.py): the phase-A
    wiring of the KTRON (pin order checked against KTRON's drawing), CP2102, 5 V
    supply, earpiece, mic and antennas.
    - Earpiece: SIMCom's A7672S reference circuit (fig. 28) and KTRON's
    speaker/mic circuit both put a 47 uF capacitor in each earpiece wire to block
    steady current through the coil. The docs said "straight across S+/S-", so
    wiring, bring-up, assembly, BOM and decisions now include the capacitors.
    - Bring-up: earpiece and mic checks that need no SIM (AT+SIMTONE, AT+CLDTMF,
    AT+CTTS, AT+CREC + AT+CCMXPLAY), wire lengths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
2026-11-05 Bring-up: when the LTE antenna is needed
    With no SIM the modem only listens, so the no-SIM checks are fine with just the
    cable. With a SIM it transmits (up to 2 W on 2G), so fit a real 700-2700 MHz SMA
    male antenna first. Also: avoid RP-SMA Wi-Fi antennas, and U.FL sockets wear out
    after about 30 plug-ins.
2026-11-05 Wire lengths from the routes; solder from the antenna-socket side
    Estimated routes through the case, plus the span with the case opened flat:
    - Data wires: about 10 cm route, so about 12 cm finished. Half a 20 cm jumper
    would be too short once its plug is cut off, so use whole jumpers.
    - Mic: 11 cm route and up to 13.4 cm opened flat, so the old 12 cm was too
    short. Now about 18 cm.
    - Earpiece: up to 8 cm opened flat, plus the capacitors. Now about 12 cm.
    Wires now enter from the antenna-socket side, so they leave into the 9 mm gap
    under the board and the soldered side stays low under the battery. The dry-fit
    list notes that the battery must slide about 2 mm down to clear the earpiece
    w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
2026-11-05 Bench test results: TX/RX go straight across; flight mode; AT+CBC reading
    First real test of the KTRON from the Mac, no SIM, no antenna:
    - The modem stayed silent with TX/RX crossed and answered as soon as they went
    straight across (CP2102 TXD to hole TX, RXD to hole RX). Wiring, bring-up,
    assembly and the bench diagram are corrected, including the T-Deck wiring.
    - It was in flight mode (AT+CFUN? = 4). AT+CFUN=1 works and is now in step 3.
    - AT+CBC reads about 0.01 V on a running modem, so AT+CPMVT=1 needs checking on
    battery first: it could turn the modem off.
    - AT+CGNSSINFO answers ERROR until +CGNSSPWR: READY!, which the guide now says.
    - Firmware recorded: A7672M7_V1.11.1.
    Co-Auth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
2026-11-05 Bench results: earpiece works; mic gets no power when recording
    - Earpiece heard on tones, speech and file playback; gain set to 7.
    - Mic recordings held no voice, but M+ to M- read 0 V during a recording with
    no short between them, so the modem seems not to power the mic outside a
    call. A silent recording no longer counts as a fault; the first call decides.
    - The modem starts in flight mode at every power-up without a SIM.
    - GPS: restart it if READY doesn't appear within a minute.
    - wiring.md: the mic's -60 dB figure has no stated reference, so drop the claim
    that it's quieter than typical.
2026-11-05 Bench results: measured supply and capacitor polarity
    C11's + leg reads 3.86 V and C17's reads 4.97 V with 5 V on VCC, so both swapped
    capacitors are the right way round and C17 fits being on the VCC input. AT+CBC's
    0.01 V is confirmed wrong.
2026-11-05 Bench results: GPS gets a 3D fix through a window
    33 satellites, HDOP 1.47, within about 7 minutes of READY. GPS is off after every
    power-up. The no-SIM bench checks are now finished; the mic waits for a real call.
2026-11-05 Bring-up: temporary battery hook-up without the MOSFET switch
    For the owner's bench tests before the switch parts arrive: battery + to C11's
    + leg through a plug (never C17, which is on VCC), battery - to the regulator's
    tab, 5 V wires kept but taped up, and never both supplies at once.
2026-11-05 Back: trim additions to the cover's shape (standoff feet poked out)
    The owner spotted it: the two standoffs by the SIM slit poked up to 1.5 mm out
    through the cover's rounded bottom edge. Their 10 mm feet and wall joins reach
    x = -3.1, but the outside face curves in to x = -1.3 near the floor. make_back.py
    now intersects every addition with the original cover's convex hull before the
    union. That removes exactly those 18.3 mm^3 and nothing else. Standoffs and
    insert holes are unchanged, and no vertex now lies outside the original shape. The
    front was checked the same way and is clean (0.02 mm rounding at the mirrored
    SMA corner). The earpiece holder still clears both halves. Pictures re-rende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
2026-11-05 Front: remove the "rushiworks" bezel engraving
    At the owner's request the front no longer carries the rushiworks text. The
    engraving step is gone from make_front.py; the rebuilt front differs from the
    last one only by the 11 refilled letter shapes (12.3 mm^3) and the bezel is
    flat. Removed the bezel callout and front-side-text.png from the diagrams, and
    the text from case/README.md and docs/case.md. Fit-test rings regenerated (they
    are cut from the front); the earpiece holder still clears both halves. The
    back's rushiWorks logo is unchanged.
2026-11-05 Delete stale and redundant case pictures
    - back-sim-slit.png still showed the standoff foot poking out (fixed today); the
    fix picture shows the slit.
    - back-preview.png, front-screen-side.png and front-cuts-inside.png were
    one-off renders that the assembly diagrams and layout pictures now cover.
    Links removed from case/README.md. Every picture left is linked from a doc.
2026-11-05 Case: all printable files in case/stl, test pieces in case/stl/test-prints
    - Moved the front, back and earpiece holder into case/stl/, and the fit-test
    rings and mic coupon into case/stl/test-prints/.
    - Added Alley Cat's Switch, Reset Button and Antenna Plug unchanged (copied from
    the Printables download, same CC BY-SA licence and credit), so everything to
    print is in one place. The plug pushes into our SMA holes, but this build
    doesn't need it because both holes carry connectors.
    - Updated every link and the rebuild commands; no broken links.
2026-11-05 Two print sets: case/stl/100 and case/stl/101
    - case/stl/100/: the six parts at normal size (front, back, earpiece holder,
    Alley Cat's Switch, Reset Button and Antenna Plug), unchanged.
    - case/stl/101/: the same six built 1 % larger for a tight T-Deck fit, using
    new --scale options rather than slicer scaling:
    - back: grows with the shell, but the four standoffs keep the board's exact
    47.90 x 50.70 mm spacing and 4.5 mm insert holes. Checked: spacing
    unchanged, nothing outside the cover, SIM slit 0.02 mm from the card.
    - front: scaled whole (mic pocket 6.30 -> 6.36 mm, opening 68.68 mm).
    - earpiece holder: outside grows with the pocket, cup stays true; clears
    both 101 %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
2026-11-06 Battery is 5000 mAh, not the 1700 mAh Micromax pack
    The owner confirmed the 65 x 55 x 9 mm cell is 5000 mAh. README, BOM,
    decisions and wiring corrected. The protection-circuit claim is now a check,
    since it was carried over from the Micromax pack.
2026-11-06 Battery: bare HH 955465 cell, add a 1S protection board
    The owner's photo shows a bare 5000 mAh pouch cell (HH 955465, 3.7 V,
    18.5 Wh, IEC 62133-2) with no protection circuit: the tabs come straight out of
    the cell, as on power-bank cells. Added a 1S Li-ion protection board (DW01A +
    8205A, 3 A or more) to the plan. Both the T-Deck and the modem connect to its
    output. Nominal 9.5 mm thickness noted: 0.4 mm spare in the depth.
2026-11-06 wiring: drop the Micromax pack's thermistor note (bare cell has none)
2026-11-06 BOM: pick the 3 A two-MOSFET 1S protection board
    Two 8205A in parallel halve the on-resistance, so the modem's 2 A bursts drop
    less voltage and stay below the overcurrent trip even on a low battery.
2026-11-06 BOM: direct Robu link for the 3A 2MOS protection board
2026-11-06 Modem power switch: SS-12F15 slide switch in Alley Cat's left-side mount
    The owner chose a physical switch (an SS-12F15 they own, 4 mm knob) over the
    MOSFET pair that followed the T-Deck.
    - make_front.py no longer fills the switch mount, so it's back exactly as in
    Alley Cat's file (0 mm^3 difference in that region). The SS-12F15 drawing
    matches it: 15 mm screw spacing, 2.2 mm holes, 19.7 x 5.6 mm plate in the
    21.6 x 8.4 mm recess, 3 x 3 mm knob with 3 mm travel in the 6.9 x 3.4 mm slot.
    - Checked with a model of the switch: no collision with either half over the
    full knob travel, M2 screws pass the holes, knob 1 mm proud, 0.5 mm above the
    T-Deck's back. The battery moves 9.1 mm ri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
2026-11-06 Antennas: plan for the internal LTE sticker antenna
    The full-band LTE sticker antenna (110 x 20 mm, U.FL) that came with the
    T-Deck can go along the inside of the back's right side, beside the
    modem board, wrapped from the floor up the wall. No case change: the SMA
    holes stay, and the antenna plug fills the top-right one when the
    sticker is used. Keep it only if its RSRP is within about 5 dB of an
    SMA antenna's in the closed case.
    - wiring.md section 6: table row, placement band, wrapping, what costs
    signal, how to decide
    - bring-up.md: comparing antennas with AT+CPSI? RSRP
    - assembly.md, decisions.md, bom.md, case.md, case/README.md, README.md
    - back inside diagram: red dashed band, call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
2026-11-07 Bench results with a Jio SIM; 101 % case fits
    - SIM: must go in with the cut corner last, on the latch side; end-to-end
    it clicks in but reads SIM REMOVED. Added to bring-up and assembly.
    - Jio 4G registered on band 5, VoLTE (IMS) registered, data up.
    - Incoming call works with clear earpiece sound at COUTGAIN 5; AT+CHUP
    ends a VoLTE call, ATH doesn't.
    - Mic gives nothing in a call; wired the right way, so probably dead or
    an open joint at the mic. Steps to fit a spare mic.
    - SMS receive works; the SIM holds only 10 messages.
    - Case: the 101 % set fits. README status and next steps updated.
2026-11-07 Case: keep only the 101 % print set, in case/stl/
    The 101 % parts printed and fit the T-Deck and all the components, so
    the 100 % set is removed and the six 101 % files move up into case/stl/.
    Both fit-test rings stay for other builders.
    - Rebuild commands now build the 101 % set from Alley Cat's originals;
    verified: all six files rebuild byte-identical.
    - Pictures and fit rings are drawn from a 100 % build in case/build100/
    (git-ignored); verified the rings rebuild byte-identical.
    - Links and wording updated in README, case/README, docs/case.md and
    docs/assembly.md: the files are already scaled, print at 100 %.
2026-11-07 BOM: everything for v1 owned except the protection board; add the Robu LoRa stubby
2026-11-07 Antennas: the T-Deck's sticker is the 4G antenna in use; SMA is a fallback
    The full-band sticker antenna from the T-Deck's box was the antenna for
    all the 7 Nov bench tests (not an SMA antenna, as the docs said). No SMA
    LTE antenna is owned. LoRa gets the 50 mm 868 MHz stubby instead.
    - bring-up: results heading corrected; the antenna check now compares
    the sticker inside the case with its own reading in the open.
    - wiring, decisions, assembly, README, bom updated to match.
2026-11-07 Case: printed in ASA (why 101 % fits); insert temperatures
2026-11-07 Back: engrave a SIM-direction picture under the slit
    A micro-SIM outline (4 x 5 mm, 0.7 mm deep) with its cut corner and a
    raised arrow into the slit, on the left wall below the SIM slit. Read
    with the phone screen-up: top edge in first, contacts down, cut corner
    on the outer end toward the USB end. Confirmed by the owner against the
    working card.
    - make_back.py: sim_icon(); the 101 % back is rebuilt.
    - make_diagrams.py: sim-picture.png close-up (depth-shaded).
    - case/README, docs/case.md, assembly, bring-up point to the picture.
2026-11-07 Back: move the SIM picture beside the slit and make it larger
    Under the slit the wall is flat for only 3 mm before it curves into the
    back's rounded edge, which spoiled the picture. It now sits on the flat
    wall beside the slit, toward the phone's top, at the slit's height:
    6 x 7.5 mm, 0.8 mm deep, same design (cut corner bottom-right, arrow up).
    101 % back, close-up, layout and stack pictures rebuilt; docs updated.
2026-11-07 Front: engrave a microSD-direction picture beside the microSD opening
    A microSD outline (5.9 x 8 mm, 0.8 mm deep) on the flat right wall beside
    Alley Cat's microSD opening, toward the phone's top, matching the SIM
    picture on the back. Raised stripes for the gold contacts and a raised
    arrow; the narrow section with its step is on the USB-end side. Read with
    the phone screen-up: contacts up, contacts end first (owner's photo).
    - make_front.py: sd_icon(); the 101 % front and both fit rings rebuilt
    (the rings slice through the picture's top). Earpiece holder unchanged.
    - make_diagrams.py: sd-picture.png close-up; front-outside key updated;
    side_closeup now orients any view correctly.
    - case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
2026-11-07 Back: GPS patch into the bottom-left corner, modem board 7 mm lower
    After the dry fit, the earpiece wires had only about 1.5 mm to pass
    between the battery's top end and the filled block between the case
    screws.
    - GPS patch centre (21.5, 26) -> (16.5, 22): 5 mm left, 4 mm down, the
    furthest into the corner with the ceramic still flat on its pads.
    - Modem board (Y0 98.3 -> 91.3) 7 mm down, with its standoffs, SIM slit
    and picture, and LED window. Battery and protection board 7 mm down.
    - Result: about 8.5 mm at the top for the earpiece wires; GPS patch to
    the internal 4G sticker about 28 mm (was 23).
    - 101 % back rebuilt; earpiece holder still fits (unchanged).
    - Diagrams follow the bo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
2026-11-07 case.md: correct the board's distance to the top block
2026-11-08 Docs: record the slim-layout brainstorm (not designed yet)
    docs/slim-layout-plan.md captures the 8 Nov 2026 brainstorm: a 103565
    battery beside the modem instead of over it (phone about 28 mm instead of
    37), GPS moved to the top pocket, 4G on an external SMA antenna, the SIM
    slit and switch moved up the left side, the speaker moved to the right
    side clear of the T-Deck holding bump, the comparison with Alley Cat's
    7 mm S back, and the open items. Linked from the README.
2026-11-08 Slim-layout plan: three options, with sketches
    Adds option 2 (case 13 mm longer at the top, the owned 5000 mAh cell
    across the bottom, below the modem; about 123 x 76 x 27.5 mm) and
    option 3 (one 18650 across the top in a grip ridge; 110 x 76 x 27.5 mm,
    33.5 at the grip) beside the existing 103565 option, with an at-a-glance
    comparison and updated open items (choose an option; the GPS antenna's
    2.7-3.3 V supply to check on U.FL2).
    Pictures are rough mock-ups from the real print files. The front view
    uses a plainly drawn T-Deck, not LilyGO's product photo.
2026-11-11 Mic: it needs a resistor from M- to GND; correct the docs
    The mic was silent in calls because nothing joined M- to ground. SIMCom's
    A7672S hardware design (figure 28) puts that 2.2 kOhm outside the module, and
    KTRON's speaker/mic drawing doesn't show it. Both mic pads read 1.65 V to
    ground with 0 V between them. With 1 kOhm from M- to GND the mic is clear and
    loud enough at AT+CMICGAIN=4.
    The docs said no extra parts were needed and blamed a dead mic. Correct the
    wiring, decisions, assembly, bring-up results and parts list, and drop the
    meter diode test, which failed a mic that works.
2026-11-11 Back: script for the 18650 version (first draft)
    Built on Alley Cat's S back, 0.5 mm deeper: round grip across the top for one
    18650, blending into the flat back at 45 degrees; modem board lower on 8 mm
    standoffs; GPS antenna on its edge in the top slot; no logo; grooves ending
    2 mm from the grip and the bottom edge. New file only: the current print set
    is unchanged. Battery contact pockets and the front's changes are still to do.
2026-11-11 Mic: the resistor is on the modem board and proven
    The 1 kOhm from M- to GND is soldered on the modem board, and calls are clear
    and loud enough at AT+CMICGAIN=4. Mark the mic step done in the README.
2026-11-11 18650 version: modem switch on the back's right wall; front and low holder
    Back (make_back_18650.py, now also reads Alley Cat's front for her switch
    mount):
    - modem switch on the right wall, just below the grip: her knob slot and
    countersunk screw holes, a 0.6 mm pad inside so the knob stands out as in
    her design, and the floor's corner cleared for the plate.
    Front (new make_front_18650.py, built on make_front.py's result):
    - left wall: SIM slit at the board's new height, in a finger scoop, with a
    larger SIM picture; her speaker grille and switch mount filled flush;
    - right wall: her exact speaker cavity and grille, moved below the T-Deck
    switch (the stretch up to the microSD slot i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
2026-11-11 Docs: the capacitor swap is already done
    C11 (470 uF) and C17 (100 uF) were swapped before the bench tests and every
    test since ran on them; mark the phase B step and the case to-do as done.
2026-11-11 18650 version: owner's logo on the top badge, Alley Cat's cat kept inside
    Front: the top-edge badge carries the rushiWorks logo (traced from
    case/logo/rushi-logo.jpg) instead of the cat. The badge is as wide as the GPS
    slot behind it (18.6 mm) and its sloped edge spans exactly the top edge's flat
    part (z -10.0 to 4.0), so it blends with the edge; logo 14.9 x 10.4 mm,
    recessed 0.5 mm, thinnest strokes widened slightly so they print.
    Back: Alley Cat's own engraved cat and "Alley Chat TD1 S" on the S back's
    inside floor are no longer filled, so her credit stays inside the case (she is
    also credited in the README and case files, as CC BY-SA asks).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
2026-11-12 18650 version: room for an 18.5 mm GPS antenna board
    Eteily quotes only the ceramic (18 x 18 x 4 mm). Like the old KTRON patch
    (sold as 25 x 25, measured 26 x 26 board) and FONCON's 18 mm patch
    (18.5 x 18.5 x 6.5 mm unit), its board is likely about 18.5 mm.
    - Slot 19.5 mm wide in the back and front (was 18.6); the logo badge follows.
    - Front: the earpiece pocket's floor 0.5 mm lower (face 3.1 mm under it).
    - Low holder: 0.2 mm left over the earpiece contacts for solder (was 0.5),
    roof 0.5 mm (was 0.6); roof now at z -8.2.
    - Antenna height room 19.1 mm: 0.6 mm spare for an 18.5 mm board.
    - Not done: thinning the back's skin or recessing its top wall, because the
    top-back edge is rounded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
2026-11-12 18650 version: battery contacts, support wall, clean side walls, print files
    - Battery contacts: held as in the holder, by lips on two ribs over the
    plate's edges (0.6 mm groove for the plate and strip), on a seat, with a
    thin bar joining the lips so the back prints standing up. Plates 72 mm
    apart at any print scale. + and - engraved on the floor.
    - Protection board glued to a support wall along the cell's modem side; its
    own nickel strips reach behind the contacts through slits, so nothing is
    soldered at the contacts. The wall's face continues the channel's curve.
    - Front, left wall: rebuilt in one piece from Alley Cat's own profile, with
    only the SIM slit and her reset opening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
2026-11-12 Docs: the 18650 design page, its pictures, and updates across the docs
    - docs/design-18650.md: what changes, the parts, battery contacts and
    protection board, wires, printing and the print files, checks before
    assembly, and what's still open; with nine pictures drawn from the case
    files by docs/scripts/make_18650_pictures.py.
    - Slim layout plan marked as chosen and designed; decisions, parts list,
    README and case README updated; pointer notes in case, wiring and
    assembly docs, which still describe the current build.
2026-11-12 18650 version: clean GPS slot over the earpiece; clear network-light tube
    - Front, top pocket: Alley Cat's earpiece pocket kept (its side walls hold
    the earpiece holder), floor lowered 0.5 mm within it; above it one clean
    19.5 mm GPS slot to the far wall, with a step on each side level with the
    holder's roof, so the antenna stands on one flat surface. Replaces the
    widened strips that stopped short of the far wall.
    - Back: the network light's bore and window are cut again after the
    standoffs, whose nearest flared foot was reaching into them.
2026-11-12 Case in version folders; ASA-only notes; 18650 wiring picture
    - case/x-back-5000mah/ and case/18650/, each with stl/ (every piece to
    print, including the reset button, the T-Deck switch slider and two
    antenna plugs, GSM and LoRa) and images/
    - Test prints, the fit-test script and build100 removed: everything is
    built at 100 % and made 1 % larger by the scripts
    - Bold notes that the case is designed for ASA only
    - docs/images: brainstorm mock-ups removed; bench wiring redrawn with the
    mic's 1 kOhm resistor; new wiring-18650.png with every wire of the
    18650 version, drawn by docs/scripts/make_wiring_pictures.py
2026-11-12 18650 version: 4G antennas chosen
    - Inside, tried first: Rajiv Electronics 41 x 12 mm flexible LTE antenna,
    along the bottom between the two lower standoffs (45 mm of room)
    - Backup: Lambdoid 50 mm right-angled stubby (Robu) in the top-right SMA
    hole, with the KTRON IPX -> SMA cable
    - Parts list, design page (fitting and signal test), README next steps
    and the wiring picture's antenna label updated
2026-11-12 Build log with labelled photos; mic resistor on the SIM-card side
    - docs/build-log.md: the hardware as built, step by step. So far the
    capacitor swap (4 Nov) and the bench tests (5-11 Nov), with sections
    waiting for the T-Deck wiring and the assembly in the printed case
    - Six photos in docs/images/build-log, made by
    docs/scripts/make_build_log_photos.py: turned upright, labelled, hidden
    data (location, camera) removed, the modem's serial number, IMEI and QR
    code blurred
    - Mic resistor: as built, on the SIM-card side, from M- to a ground point
    (wiring.md, assembly.md, bring-up.md and the wiring pictures)
    - Mic now on yellow (+) and green (-) wires; C11 was 330 uF 35 V, not 50 V
    C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
2026-11-12 Build log photos: backgrounds removed, modem make and model shown
    - All six photos lifted off their backgrounds with macOS's own "lift
    subject" (docs/scripts/lift_subject.swift) and put on white, with a
    soft shadow; the hand trimmed from the two hand-held photos; thin wires
    the lifting lost traced back from the photo
    - Only the modem's serial number, IMEI and QR code are blurred now. Its
    make, model (SIMCom A7672S) and part number stay readable, and every
    photo labels it as the 4G modem chip
    - Build log: why the IMEI is hidden, and tips for photos that lift cleanly
2026-11-13 18650 back: clean ends on the grip
    - The lower contact rib and the contact's seat reached through the grip's
    outside at both ends (up to 0.7 mm, about 82 mm up): the contact
    holders now end 0.4 mm below the channel's floor, on its own curve
    - The grip's slices follow Alley Cat's cross-section at each height, so
    its top ends fade into her rounded corners instead of leaving a thin
    ledge past them
    - The grip is built from the same points in every slice (no ray
    sampling), so its rounded side edges are smooth, with no fine sawtooth
    - Print file and the five pictures that show the back's outside redrawn
2026-11-13 18650 version: assembly steps, open-book wiring picture, wire lengths
    - docs/assembly-18650.md: a draft of the step-by-step assembly, written
    from the 3D model, with a dry-fit checklist
    - New pictures: every wire with the case open like a book (the T-Deck's
    back placed from LilyGO's board drawing and pin map), and the battery
    corner in the order the parts go in
    - Cut length for every wire. The battery lead and the 4G stubby's cable
    cross on the right, so the lead is plugged in last, at closing
    - Corrected from LilyGO's published files: the T-Deck's battery socket is
    a JST GH 1.25 mm (not PH2.0), and its Grove socket is near its left
    edge, not top-right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
2026-11-13 Test program for the assembled phone, and the test checklist
    - firmware/test-program: a small T-Deck program (PlatformIO). It shows
    the modem's state on the screen: modem, SIM, network, VoLTE, 4G
    signal with a 5-reading average for the antenna test, battery, GPS,
    calls and SMS. It passes the Mac's terminal through to the modem, and
    beeps on the speaker at start and on every ring. Pins and display
    start-up from LilyGO's T-Deck examples. Builds (5 % of flash); not run
    on the T-Deck yet. No numbers, IMEI or position on the screen
    - The Arduino framework 2.0.9 comes from Espressif's GitHub release:
    PlatformIO's servers kept stalling on it
    - docs/test-18650.md: one round of tests af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
2026-11-13 Test checklist: calibrate the touch screen; no settings backup
    - Section 9: calibrate the touch screen if taps miss (Meshtastic 2.7.26
    uses a different T-Deck touch driver than 2.7.10; needed on the owner's
    T-Deck on 13 Nov 2026, fine afterwards), and how to reach the
    calibration with the trackball.
    - No backup of Meshtastic's settings before the test program, and no
    restore afterwards: the test program uses the same storage layout as
    Meshtastic (default_16MB.csv) and never writes to the settings' part,
    so putting back only Meshtastic's program keeps the old name and
    channels. The test program's README says the same.
